JaxRaffnix/sdr-analog-frontend/README.md

# SDR Analog Frontend

The PCB is ordered from [Aisler](https://aisler.net/p/YPFMCLNO).
