JaxRaffnix/sdr-analog-frontend/pcb/main_v2/main_v2_report.txt

PCB statistics report
=====================
- Date: 12.07.2026 20:23:29
- Project: main_v2
- Board name: main_v2

Board
-----
- Width: 204,6625 mm
- Height: 68,5000 mm
- Area: 14019,381 mm²
- Front copper area: 12829,991 mm²
- Back copper area: 487,205 mm²
- Min track clearance: 0,1190 mm
- Min track width: 0,2000 mm
- Min drill diameter: 0,3048 mm
- Board stackup thickness: 1,5790 mm

- Front footprint area: 2778,506 mm²
- Back footprint area: 928,617 mm²
- Front component density: 19,82 %
- Back component density: 6,62 %
Pads
----
- Through hole: 27
- SMD: 516
- Connector: 0
- NPTH: 5
- Castellated: 0
- Press-fit: 0

Vias
----
- Through vias: 806
- Blind vias: 0
- Buried vias: 0
- Micro vias: 0

Components
----------

| | Front Side | Back Side | Total |
|---|---|---|---|
|THT: | 10 | 0 | 10 |
|SMD: | 171 | 0 | 171 |
|Unspecified:  | 10 | 0 | 10 |
|Total: | 191 | 0 | 191 |

Drill holes
-----------

| Count | Shape | X Size | Y Size | Plated | Via/Pad | Start Layer | Stop Layer |
|---|---|---|---|---|---|---|---|
| 796 | Round | 0,3048 mm | 0,3048 mm | PTH | Via | F.Cu | B.Cu |
| 21 | Round | 1,0000 mm | 1,0000 mm | PTH | Pad | F.Cu | B.Cu |
| 10 | Round | 0,4064 mm | 0,4064 mm | PTH | Via | F.Cu | B.Cu |
| 4 | Round | 2,2000 mm | 2,2000 mm | NPTH | Pad | F.Cu | B.Cu |
| 2 | Round | 2,5000 mm | 2,5000 mm | PTH | Pad | F.Cu | B.Cu |
| 2 | Round | 0,8000 mm | 0,8000 mm | PTH | Pad | F.Cu | B.Cu |
| 1 | Round | 1,6000 mm | 1,6000 mm | NPTH | Pad | F.Cu | B.Cu |
| 1 | Round | 3,0000 mm | 3,0000 mm | PTH | Pad | F.Cu | B.Cu |
| 1 | Round | 2,3000 mm | 2,3000 mm | PTH | Pad | F.Cu | B.Cu |
