JaxRaffnix/sdr-analog-frontend/docs/design/Bauteilauswahl.docx

# Bauteilauswahl

SDR Analog Frontend

Alle verlinkten Bauteile sind auf Mouser/Digikey vorrätig

# Software Defined Radio

SDR | Signal | Terminierung | | Peak-to-Peak Differential | Output Power Max | Input Power Max
RFSoC_RM_A3 (https://www.realdigital.org/hardware/rfsoc-4x2) | 900 – 1000 Mhz | 100 Ohm | | 4,8 V | -18,5 – 6,6 dBm | 14m 6 dBm

Am ADC und DAC des RFSoC befinden sich MABA-011118 Baluns, diese erzeugen ein Single-Ended 50 Ohm Signal!

# Power

Power Supply über 5V USB- Gerät.

https://www.amazon.de/AC-DC-Netzteil-Stecker-Plug/dp/B0BYS9Y2B6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

Input | Spannung | Strom Max | Leistung Max
USB A Jack (https://www.mouser.de/ProductDetail/Wurth-Elektronik/692122030100?qs=e5m3IbTHPW%252BwkSEzX%252BzXuw%3D%3D) | 5 V | 1.8 A | 9 W

Power Management | Input Voltage | Output Current Max | Kosten
AP22804AW5-7 (https://www.mouser.de/ProductDetail/Diodes-Incorporated/AP22804AW5-7?qs=lqAf%2FiVYw9hgcUuNhFapmA%3D%3D) | 2,7 – 5,5 V | 2,5 A | 0,32 €

3,3 V Linear Dropout-Regulator | Input Voltage Max | Output Current Max | Kosten
LT3042 (https://www.mouser.de/ProductDetail/Analog-Devices/LT3042EMSEPBF?qs=oahfZPh6IAJ3XP16d20ITw%3D%3D) | 1,8V – 20V | 200 mA | 6,49 €

# Oszillator

Zielfrequenz von 1.5 GHz wird mit temperaturkontrolliertem Oszillator erreicht.

Um aus dem LVDS-Signal einen glatten Sinus ohne Gleichanteil un 50 Ohm Terminierung zu erzeugen, wird ein 1:2 Balun, Tiefpass und Blocking Kondensatoren verwendet.

Das Signal wird gesplittet und für jeweils den Rx und Tx Pfad verstärkt.

Oszillator | Frequenz | Frequenzstabilität | Supply Voltage | Input Current Max | Output | Kosten
ASG-D-X-A-1.500GHZ (https://www.mouser.de/ProductDetail/ABRACON/ASG-D-X-A-1.500GHZ?qs=EvNa9vf1TdY1witycQX%252Bjg%3D%3D) | 1,5 GHz | 50 ppm | 3,3 V | 40 mA | LVDS | 13,62 €
ASGTX-P-1.500GHz-1 (https://www.mouser.de/ProductDetail/ABRACON/ASGTX-P-1.500GHz-1?qs=6DDkx98%252BHnBmxjjunHEfJg%3D%3D) | 1.5 GHz | 1 ppm | 3,3 V | 60 mA | LVPECL | 72,01 €

RF Balun | Frequenzbereich | Insertion Loss | Input Termination | Ouptut Termination | Kosten
XMB0220K1-50100G (https://www.mouser.de/ProductDetail/TTM-Technologies/XMB0220K1-50100G?qs=4dK74SdgGtzjn4qZiEqOfQ%3D%3D) | 180 – 1900 MHz | | 50 Ohm | 100 Ohm | 16,68 €

Tiefpass | Frequenz | Insertion Loss | Termination | Kosten
LFCN-1700D+ (https://www.mouser.de/ProductDetail/Mini-Circuits/LFCN-1700D%2b?qs=xZ%2FP%252Ba9zWqZu7I6a3Z3VTA%3D%3D) | DC – 1700 MHz | | 50 Ohm | 11,32 €

Power Splitter | Frequenz | Termination | Kosten
PD0922J5050S2HF (https://www.mouser.de/ProductDetail/TTM-Technologies/PD0922J5050S2HF?qs=61pwXRo0i5gy90xR1sGBbQ%3D%3D) | 950 – 2150 MHz | 50 Ohm | 0,72 €

Verstärker | Frequenz | Gain | P1dB | Insertion Loss | Drain Voltage | Current Max | Kosten
SPF5043Z (https://www.mouser.de/ProductDetail/Qorvo/SPF5043Z?qs=p6lVfQR1GSoUob90DTnCEA%3D%3D) | 50 – 4000 MHz | 12.9 dB @ 1960 MHz | | | 5 V | 100 mA | 5,25 €

# Mischer

HF Mixer | Frequenz | P1dB | Insertion Loss | LO Power | IF Current | RF Power | Kosten
RMaS-30+ (https://www.mouser.de/ProductDetail/Mini-Circuits/RMS-30%2b?qs=Znm5pLBrcAIBkcPltAJrPg%3D%3D) | 200 – 3000 MHz | | | 7 dBm | 40mA | 200 mW | 14,72 €

# Bandpass Zielfrequen

Der Bandpass sorgt dafür, dass nur die Zielfrequenz verarbeitet wird im Rx oder Tx pfad.

Bandpass | Frequenz | P1dB | Termination | Kosten
2450BP08A0100001T (https://www.mouser.de/ProductDetail/Johanson-Technology/2450BP08A0100001T?qs=jRuttqqUwMTNv6S8vKwCpQ%3D%3D) | 2400 – 2500 MHz | 22.7 dBm | 50 Ohm | 1,14 € x2

# Transmitter

Verstärker | Frequenz | P1dB | Insertion Loss | Max Input Power | Voltage | Strom Max | Kosten
SE2576L-R (https://www.mouser.de/ProductDetail/Skyworks-Solutions-Inc/SE2576L-R?qs=WMHGlxXAKT%252BgTam3WBvNxQ%3D%3D) | 2400 – 2500 MHz | 32 dBm | | 12.0 dBm | 5 V | 500 mA | 1,31 €

# Receiver

Low Noise Amplifier | Frequenz | Gain | P1dB | Rauschzahl | Insertion Loss | Spannung | Strom Max | Kosten
HMC374 (https://www.mouser.de/ProductDetail/Analog-Devices/HMC374E?qs=pceeu5JH%2FH8ggZVEBU5WpA%3D%3D) | 2.0 - 3.0 GHz | 9 dB | 22 dBm | 1.5 dB | | 5 V | 90 mA | 7,64 €

Bandpass | Frequenz | P1dB | Insertion Loss | Termination | Kosten
SYBP-92+ (https://www.mouser.de/ProductDetail/Mini-Circuits/SYBP-92%2b?qs=Znm5pLBrcAKU8e7zMrX60g%3D%3D) | 800 – 1000 MHz | | 2.24 dB | 50Ω | 20,92 €

# Power limiter

SKY16602-632LF

Bei digikey: https://www.digikey.de/en/products/detail/skyworks-solutions-inc/SKY16602-632LF/4959401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

# Kleinkram

- PESD5V0L1UL
- Button_Switch_SMD:SW_DIP_SPSTx01_Slide_6.7x4.1mm_W6.73mm_P2.54mm_LowProfile_JPin
- LED_SMD:LED_0603_1608Metric
- Capacitor_Tantalum_SMD:CP_EIA-6032-20_AVX-F
- LQG15HN1N5S02D
- Connector_Coaxial:SMA_Amphenol_132289_EdgeMount
- Connector barrel jack: https://www.mouser.de/ProductDetail/Same-Sky/PJ-063AH?qs=WyjlAZoYn51bQfA53nMcVA%3D%3D

Antenne:

Antenne an Rx out & Tx Out:

ANT-2.4-LCW-SMA

https://www.mouser.de/ProductDetail/TE-Connectivity-Linx-Technologies/ANT-2.4-LCW-SMA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

Peak Gain: 2.8dBi

Average gain: -0.6dBi typical

VSWR: <2:1
