JaxRaffnix/sdr-analog-frontend/docs/design/PCB Kosten.png

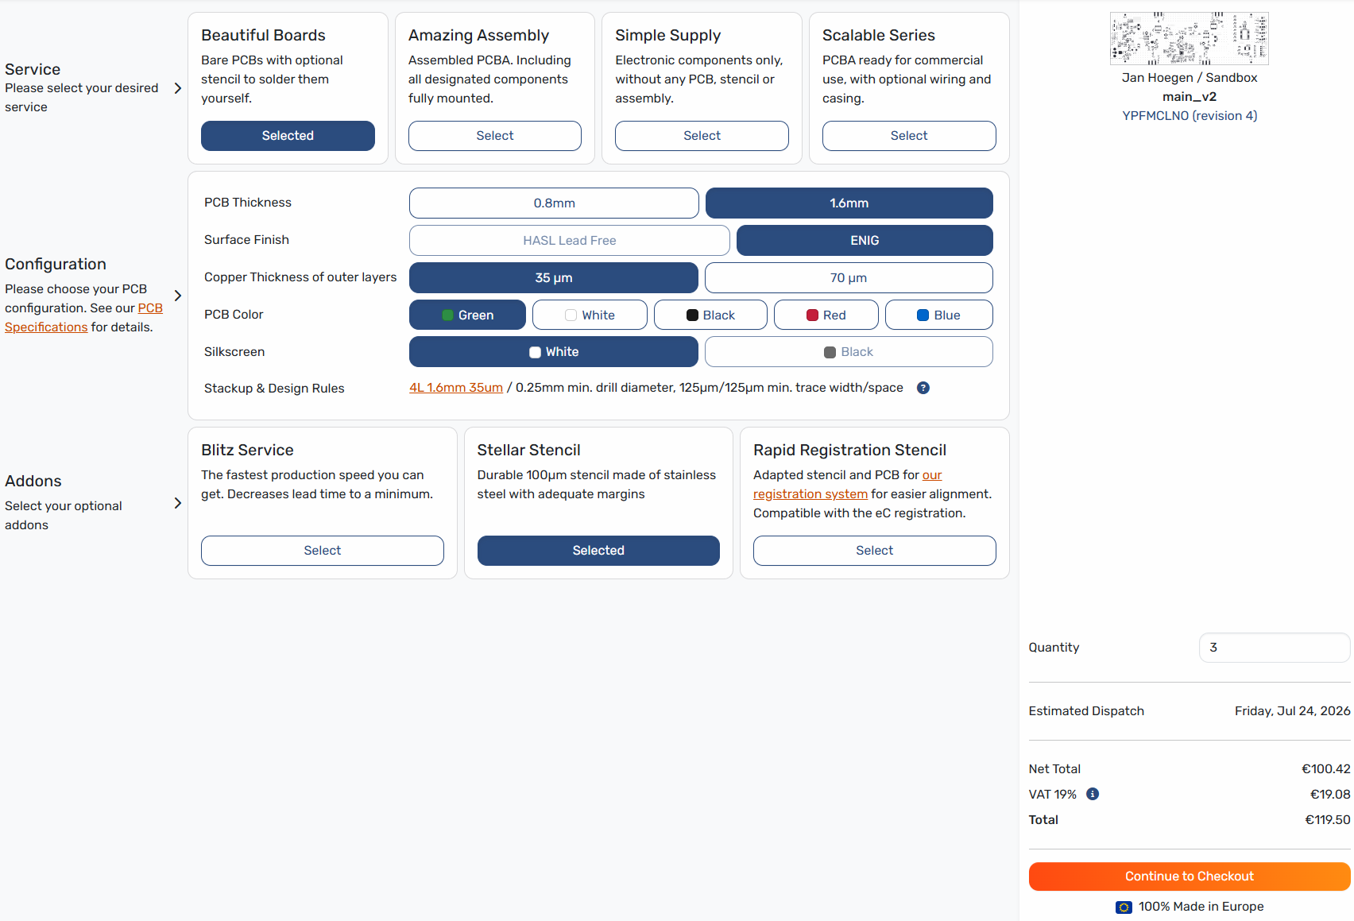
docs/design/PCB Kosten.png
