JaxRaffnix/sdr-analog-frontend/simulation/images/DC Power.png

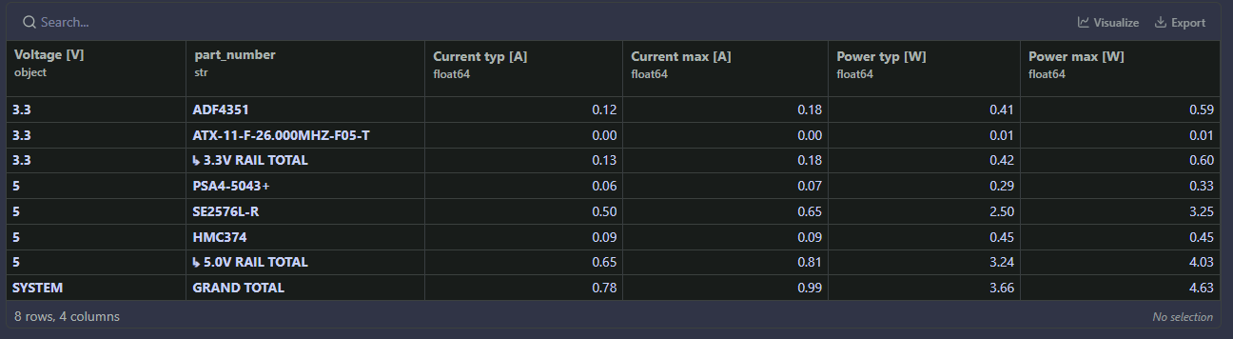
simulation/images/DC Power.png
