JaxRaffnix/sdr-analog-frontend/simulation/images/Oszillator.png

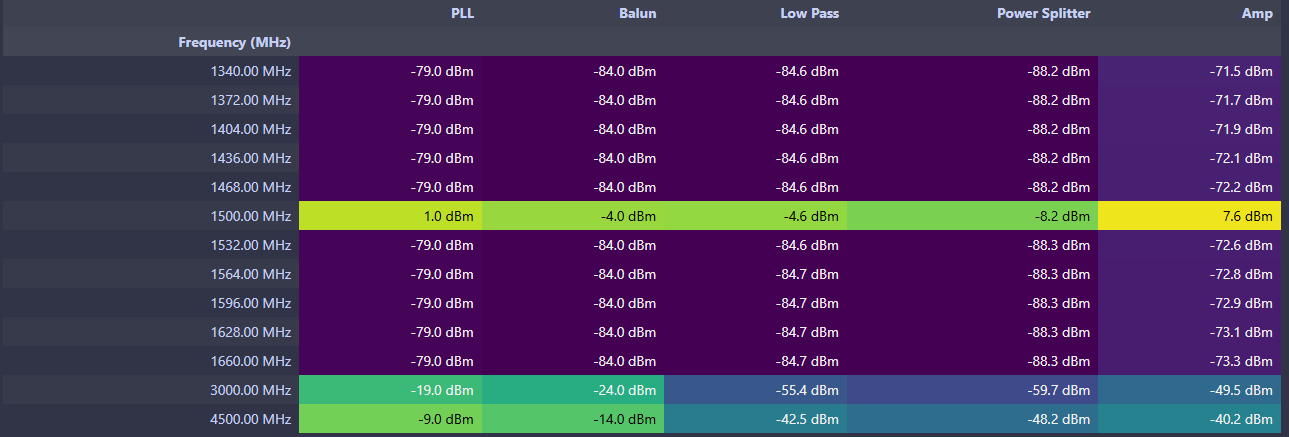
simulation/images/Oszillator.png
