JaxRaffnix/sdr-analog-frontend/simulation/images/Receiver.png

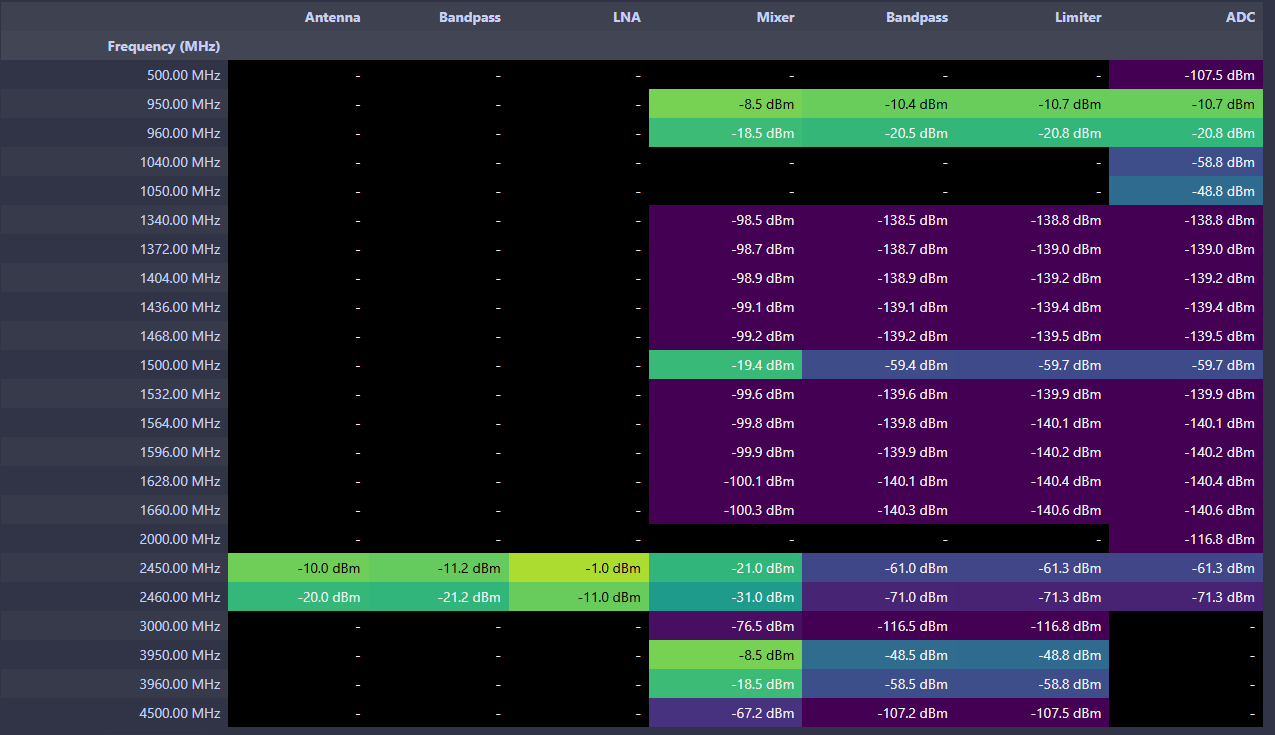
simulation/images/Receiver.png
