JaxRaffnix/sdr-analog-frontend/simulation/images/snr.png

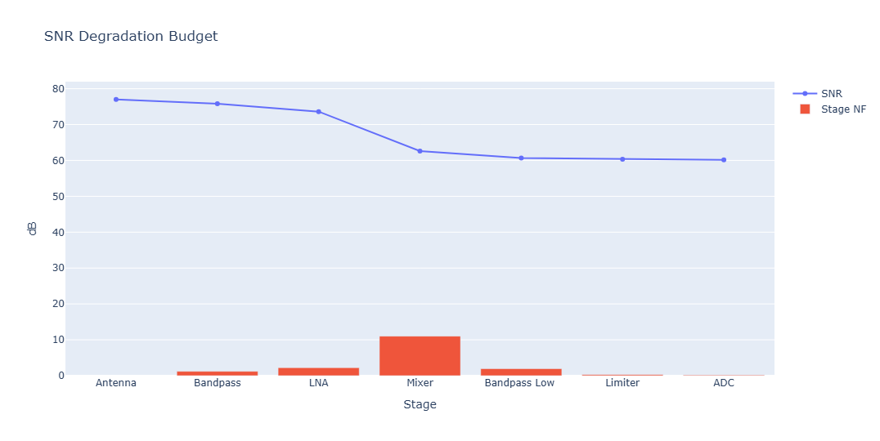
simulation/images/snr.png
