JaxRaffnix/sdr-analog-frontend/simulation/images/Transmitter.png

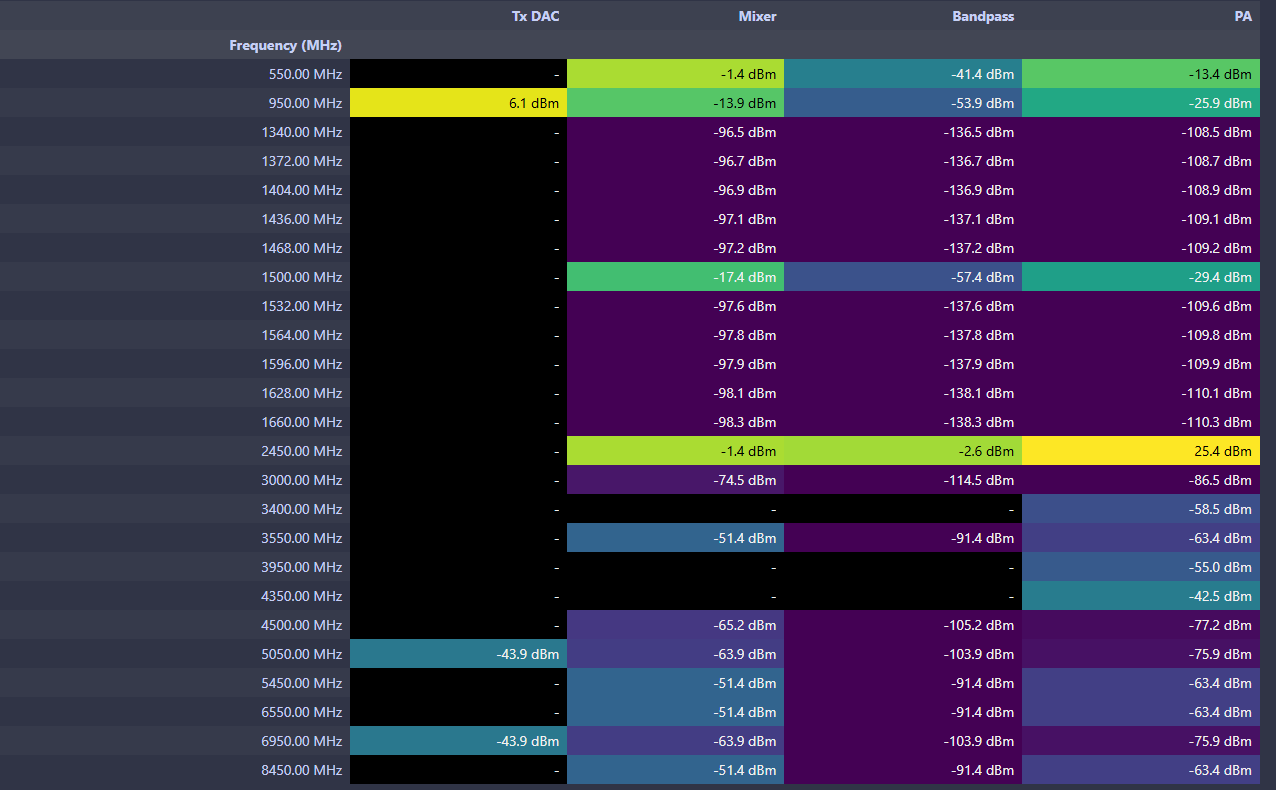
simulation/images/Transmitter.png
