JaxRaffnix/sdr-analog-frontend/docs/hka/Bestellungen/Bestellung.xlsx

Sheet: Tabelle1
Lieferant
Firma |  | Mouser Electronics, Inc.
Straße +HNr |  | Georg-Brauchle-Ring 53 (https://www.mouser.de/contact/)
PLZ,Ort |  | 80992 Munich (https://www.mouser.de/contact/)
ggf. Webseite |  | https://www.mouser.de/en/
E-Mail: (Lieferant) |  | muenchen@mouser.com
Angebotsnummer:
Wer Zahlt?
Kostenstelle:
Fond:
oder PSP Element
Wer will es haben?
Besteller: |  | Jan Hoegen
Raum: |  | N-206
ggf. Betreuer |  | Tristan Itschner
 |  |  | Preise Ohne MwSt!
Stückzahl | Artikel.-Nr. | Beschreibung | Einzel Preis € | Summe € | Bestell-Links
5 | CC0603KPX7R8BB105 (https://www.mouser.de/de/ProductDetail/YAGEO/CC0603KRX7R9BB104) | Kondensator aus mehreren Keramikschichten MLCC - SMD/SMT 25V 1uF X7R 0603 10% HI CV | 0.21 € | 1.03 €
10 | CC0603MRX7R5BB475 (https://www.mouser.de/de/ProductDetail/YAGEO/CC0603MRX7R5BB475) | Kondensator aus mehreren Keramikschichten MLCC - SMD/SMT 6.3V 4.7uF X7R 0603 20% HI CV | 0.46 € | 4.64 €
5 | CC0603KRX7R9BB104 (https://www.mouser.de/de/ProductDetail/YAGEO/CC0603KRX7R9BB104?qs=vTakOoo5QyLvVCYM2ge8LQ%3D%3D) | Kondensator aus mehreren Keramikschichten MLCC - SMD/SMT 50 V 0.1uF X7R 0603 10% | 0.09 € | 0.43 €
5 | TPSF157K010R0200 (https://www.mouser.de/de/ProductDetail/KYOCERA-AVX/TPSF157K010R0200?qs=%2FAyNC%2FU1o91Nx%252BUpVCohjg%3D%3D) | Tantalkondensatoren - fest für SMD 10V 150uF 10% Tol. 200 ESR | 2.82 € | 14.10 €
20 | CQ0402FRNPO9BN100 (https://www.mouser.de/de/ProductDetail/YAGEO/CQ0402FRNPO9BN100) | Kondensator aus mehreren Keramikschichten MLCC - SMD/SMT 50 V 10 pF C0G 0402 1% | 0.16 € | 3.26 €
12 | C0402T101J5GACTU (https://www.mouser.de/de/ProductDetail/KEMET/C0402T101J5GACTU?qs=u4fy%2FsgLU9PLUPqqcVgCTA%3D%3D) | Kondensator aus mehreren Keramikschichten MLCC - SMD/SMT 50V 100pF C0G 0402 5% | 0.78 € | 9.40 €
5 | CM03X5R105M06AH (https://www.mouser.de/de/ProductDetail/KYOCERA-AVX/CM03X5R105M06AH?qs=rkhjVJ6%2F3ELzWF91DLscGA%3D%3D) | Kondensator aus mehreren Keramikschichten MLCC - SMD/SMT KGM03BR50J105MH NEW GLOBAL PN 1uF 20% 6. A 581-KGM03BR50J105MH | 0.10 € | 0.47 €
10 | C0402X7R1A102K020BC (https://www.mouser.de/de/ProductDetail/TDK/C0402X7R1A102K020BC?qs=Zt%252BKPUOg4oeVeDoDR%252BkQnw%3D%3D) | Kondensator aus mehreren Keramikschichten MLCC - SMD/SMT 01005 10V 1000pF X7R 10% T: 0.2mm | 0.13 € | 1.29 €
5 | VJ0402D2R2BXCAJ (https://www.mouser.de/de/ProductDetail/Vishay-Vitramon/VJ0402D2R2BXCAJ) | Kondensator aus mehreren Keramikschichten MLCC - SMD/SMT 0402 2.2pF 200V C0G +/-.01pF HIFREQ | 0.58 € | 2.88 €
5 | 04026W475MAT2A (https://www.mouser.de/de/ProductDetail/KYOCERA-AVX/04026W475MAT2A) | Kondensator aus mehreren Keramikschichten MLCC - SMD/SMT 6.3V 4.7Uf 0402 20% | 0.34 € | 1.68 €
5 | VJ0402D150FXCAJ (https://www.mouser.de/de/ProductDetail/Vishay-Vitramon/VJ0402D150FXCAJ) | Kondensator aus mehreren Keramikschichten MLCC - SMD/SMT 0402 15pF 200V C0G 1% HI FREQ | 0.56 € | 2.80 €
5 | CC0402KRX5R8BB104 (https://www.mouser.de/de/ProductDetail/YAGEO/CC0402KRX5R8BB104?qs=KosDah%252BIqW%252Br%2Fi6bZws5wg%3D%3D) | Kondensator aus mehreren Keramikschichten MLCC - SMD/SMT 25 V 0.1uF X5R 0402 10% | 0.09 € | 0.43 €
5 | GCM1555C1H3R2CA16D (https://www.mouser.de/de/ProductDetail/Murata-Electronics/GCM1555C1H3R2CA16D?qs=b6dFT0v%2Fxb9um9LTQ3aBBQ%3D%3D) | Kondensator aus mehreren Keramikschichten MLCC - SMD/SMT 3.2 pF 50 VDC 0.25 pF 0402 C0G (NP0) AEC-Q200 | 0.13 € | 0.65 €
10 | 0402YU2R4BAT2A (https://www.mouser.de/de/ProductDetail/KYOCERA-AVX/0402YU2R4BAT2A?qs=ZwvTZoB9SO%2F9xc3E5Q%252BCrg%3D%3D) | Kondensator aus mehreren Keramikschichten MLCC - SMD/SMT 16V 2.4pF C0G 0402 0 .1pF | 0.12 € | 1.20 €
5 | TRJC475K035RRJ (https://www.mouser.de/de/ProductDetail/KYOCERA-AVX/TRJC475K035RRJ?qs=utR%252BHFm0FzLRVcCCl%252BXb7w%3D%3D) | Tantalkondensatoren - fest für SMD 4.7uF +/-10% 35V | 0.90 € | 4.52 €
5 | VJ0603Y102MXAAC (https://www.mouser.de/de/ProductDetail/Vishay-Vitramon/VJ0603Y102MXAAC?qs=tKBoUWxeOJbblqoMJ9HNGg%3D%3D) | Kondensator aus mehreren Keramikschichten MLCC - SMD/SMT 1000pF 50volts X7R 20% | 0.17 € | 0.86 €
10 | CC0402JPNPO9BN151 (https://www.mouser.de/de/ProductDetail/YAGEO/CC0402JPNPO9BN151?qs=tS%2FAHvPQ%2F54Y2RC7yI%252Bzfg%3D%3D) | Kondensator aus mehreren Keramikschichten MLCC - SMD/SMT 50 V 150pF C0G 0402 5% | 0.09 € | 0.86 €
5 | 06035C331M4T2A (https://www.mouser.de/de/ProductDetail/KYOCERA-AVX/06035C331M4T2A?qs=ZBeOGGPQgEHm0YWrnTdMuA%3D%3D) | Kondensator aus mehreren Keramikschichten MLCC - SMD/SMT 50V 330pF X7R 0603 2 0% AEC-Q200 | 0.21 € | 1.03 €
5 | VJ1206A331JXAAT (https://www.mouser.de/de/ProductDetail/Vishay-Vitramon/VJ1206A331JXAAT?qs=2M%252BU6H05pn89jvT56Cs8tw%3D%3D) | Kondensator aus mehreren Keramikschichten MLCC - SMD/SMT 330pF 50volts C0G 5% | 0.32 € | 1.59 €
5 | CC1206KFX5R7BB106 (https://www.mouser.de/de/ProductDetail/YAGEO/CC1206KFX5R7BB106?qs=mzRxyRlhVdtbHnIGelyb5g%3D%3D) | Kondensator aus mehreren Keramikschichten MLCC - SMD/SMT 16V 10uF X5R 1206 10% HI CV | 0.40 € | 2.02 €
25 | CC0402KRX7R7BB104 (https://www.mouser.de/de/ProductDetail/YAGEO/CC0402KRX7R7BB104?qs=AgBp2OyFlx%252BSOyhfyS7hpw%3D%3D) | Kondensator aus mehreren Keramikschichten MLCC - SMD/SMT 16 V 0.1uF X7R 0402 10% | 0.09 € | 2.15 €
5 | 04023A1R0DAT2A (https://www.mouser.de/de/ProductDetail/KYOCERA-AVX/04023A1R0DAT2A?qs=FkeSXReRH1vgN2x1fywzxw%3D%3D) | Kondensator aus mehreren Keramikschichten MLCC - SMD/SMT 25V 1pF C0G 0402 .5p F Tol | 0.15 € | 0.78 €
5 | AC0402KRX7R9BB272 (https://www.mouser.de/de/ProductDetail/YAGEO/AC0402KRX7R9BB272?qs=iHX4uCgIbgNWchYmcffrcg%3D%3D) | Kondensator aus mehreren Keramikschichten MLCC - SMD/SMT 50V 2700pF X7R 0402 10% AEC-Q200 | 0.09 € | 0.43 €
5 | CC0402KRX7R7BB393 (https://www.mouser.de/de/ProductDetail/YAGEO/CC0402KRX7R7BB393?qs=5q%252BqlK8CmJSJTmxHu%252BIslQ%3D%3D) | Kondensator aus mehreren Keramikschichten MLCC - SMD/SMT 16V 0.039uF X7R 0402 10% | 0.09 € | 0.43 €
5 | AC0402KRX7R9BB122 (https://www.mouser.de/de/ProductDetail/YAGEO/AC0402KRX7R9BB122?qs=W0yvOO0ixfHbVYdJnLy%252BqQ%3D%3D) | Kondensator aus mehreren Keramikschichten MLCC - SMD/SMT 50V 1200pF X7R 0402 10% AEC-Q200 | 0.09 € | 0.43 €
5 | VJ0402A121JXAAC (https://www.mouser.de/de/ProductDetail/Vishay-Sprague/VJ0402A121JXAAC?qs=3Pj1lnMdkfqiKcr%252BAQDyOQ%3D%3D) | Kondensator aus mehreren Keramikschichten MLCC - SMD/SMT VJ0402A121JXAAC00 | 0.33 € | 1.64 €
 |  |  |  | 0.00 €
5 | GRM1555CYA103GE01J (https://www.mouser.de/de/ProductDetail/Murata-Electronics/GRM1555CYA103GE01J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) | Kondensator aus mehreren Keramikschichten MLCC - SMD/SMT 0.01 uF 35 VDC 2% 0402 C0G (NP0) | 0.14 € | 0.69 €
3 | DESD5V0U1BL-7B | ESD Protection Diodes / TVS Diodes LowCap BiDirectional 1Ch TVS 3A 250mW | 0.21 € | 0.62 €
6 | SM0805GC (https://www.mouser.de/de/ProductDetail/Bivar/SM0805GC?qs=umy9uXsUyyaRZQCOkrRsOQ%3D%3D) | Einfarbige LEDs leds Green 568nm Water Clear | 0.87 € | 5.21 €
5 | LSM0805412V (https://www.mouser.de/de/ProductDetail/VCC/LSM0805412V?qs=T3oQrply3y%2F3hzU4lskNyg%3D%3D) | Einfarbige LEDs leds 0805 2V 100mcd Red | 0.28 € | 1.38 €
2 | 28C0236-0JW-10 | Ferrite Beads 998ohms 100MHz 5A Thru-hole | 1.14 € | 2.28 € | https://www.mouser.de/en/ProductDetail/Laird/28C0236-0JW-10?qs=wjes1ZhMGKc2BBahb2yqoA%3D%3D
5 | BLM18PG121SN1D | Ferrite Beads 120 OHM 25% Alternate Sizing Guide Below | 0.09 € | 0.43 € | https://www.mouser.de/en/ProductDetail/Murata-Electronics/BLM18PG121SN1D?qs=tY8e8KZalarVxhnmnUYZ1A%3D%3D
5 | 2450BP08A0100T (https://www.mouser.de/en/ProductDetail/Johanson-Technology/2450BP08A0100T?qs=YCa%2FAAYMW02eslDA1%2Fi8Rw%3D%3D) | Signal Conditioning PLEASE SEE GLOBAL MFG PN: 2450BP08A0100001T | 0.53 € | 2.62 €
1 | SYBP-92+ | Signal Conditioning Lumped LC Band Pass Filter, 800 - 1000 MHz, 50? | 20.92 € | 20.92 €
 |  |  |  | 0.00 €
2 | AP22811AW5-7 | Power Switch ICs - Power Distribution Load Switch | 0.34 € | 0.67 € | https://www.mouser.de/en/ProductDetail/Diodes-Incorporated/AP22811AW5-7?qs=lqAf%2FiVYw9gUYgIV6BQI1w%3D%3D
2 | RMS-30+ (https://www.mouser.de/en/ProductDetail/Mini-Circuits/RMS-30%2b?qs=Znm5pLBrcAIBkcPltAJrPg%3D%3D) | RF Mixer Level 7, SMT Double Balanced Mixer, RF/LO Freq 200 - 3000 MHz | 14.72 € | 29.44 €
2 | SE2576L-R | RF Amplifier 2.4GHz P1dB 32dBm 5.0Volt 802.11bgn | 1.31 € | 2.62 € | https://www.mouser.de/en/ProductDetail/Skyworks-Solutions-Inc/SE2576L-R?qs=WMHGlxXAKT%252BgTam3WBvNxQ%3D%3D
1 | HMC374SC70E (https://www.mouser.de/en/ProductDetail/Analog-Devices/HMC374SC70E?qs=pceeu5JH%2FH8aAWz5sXQxvw%3D%3D) | RF Amplifier lo Noise amp | 7.08 € | 7.08 €
2 | PGA-103+ | RF Amplifier ML AMPL / SURF MT / 4GHZ RoHS | 2.82 € | 5.64 € | https://www.mouser.de/en/ProductDetail/Mini-Circuits/PGA-103%2b?qs=xZ%2FP%252Ba9zWqZWniifnGTm5A%3D%3D
 |  |  |  |  | https://www.mouser.de/en/ProductDetail/Mini-Circuits/PSA4-5043%2b?qs=xZ%2FP%252Ba9zWqbLkryIxS%2FdVA%3D%3D
2 | 74LVC4T3144PWJ | Buffers & Line Drivers 74LVC4T3144PW/SOT402/TSSOP14 | 0.70 € | 1.41 €
1 | LTC6992CS6-4#TRMPBF | Switching Controllers TimerBlox: V-Controlled Pulse Width Mod | 4.78 € | 4.78 € | https://www.mouser.de/en/ProductDetail/Analog-Devices/LTC6992CS6-4TRMPBF?qs=hVkxg5c3xu8%252B3R%2FY9NegPg%3D%3D
3 | 74LVC244AD-Q100J | Buffers & Line Drivers 74LVC244AD-Q100/SOT163/SO20 | 0.49 € | 1.47 € | https://www.mouser.de/en/ProductDetail/Nexperia/74LVC244AD-Q100J?qs=cbprxTG2Yq%252B6VesrNbHshg%3D%3D
4 | 901-10309 (https://www.mouser.de/en/ProductDetail/Amphenol-RF/901-10309?qs=OWKQh20chuqRtazHxMcApw%3D%3D) | RF Connectors / Coaxial Connectors SMA End Launch PCB Jack | 7.50 € | 30.00 €
2 | PJ-063AH | DC Power Connectors Power Jacks | 1.28 € | 2.56 € | https://www.mouser.de/en/ProductDetail/Same-Sky/PJ-063AH?qs=WyjlAZoYn51bQfA53nMcVA%3D%3D
6 | CONMHF1-SMD-T | RF Connectors / Coaxial Connectors MHF1 Connector Receptacle, Male Pin 50 Ohm Surface Mount Solder | 0.53 € | 3.15 € | https://www.mouser.de/en/ProductDetail/TE-Connectivity-Linx-Technologies/CONMHF1-SMD-T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
2 | D01-9970642 (https://www.mouser.de/en/ProductDetail/Harwin/D01-9970642) | IC & Component Sockets D01 6 WAY SIL HORIZ SMT SKT T&R | 0.68 € | 1.36 €
6 | D01-9970342 (https://www.mouser.de/en/ProductDetail/Harwin/D01-9970342) | IC & Component Sockets D01 3 WAY SIL HORIZ SMT SKT T&R | 0.48 € | 2.89 €
6 | DW-01-07-T-S-200 (https://www.mouser.de/en/ProductDetail/Samtec/DW-01-07-T-S-200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) | Board to Board & Mezzanine Connectors Flexible Board Stacking Header with Fixed Tail Length | 0.09 € | 0.52 €
5 | LQG15HN1N5S02D | HF-Induktivitäten – SMD 1.5 NH +-.3NH | 0.09 € | 0.43 €
5 | CE0603M-27NH (https://www.mouser.de/de/ProductDetail/Bourns/CE0603M-27NH) | HF-Induktivitäten – SMD Ind,0.6x0.3x0.3mm,27nH3%,140mA | 0.09 € | 0.43 €
5 | MLG1005S12NHT000 (https://www.mouser.de/de/ProductDetail/TDK/MLG1005S12NHT000?qs=sGAEpiMZZMv126LJFLh8y5lwrxezZJ61LKcwM8yM6hA%3D) | HF-Induktivitäten – SMD IND 0402 12nH StdQ SMD RF IND | 0.09 € | 0.43 €
5 | LQW2UASR62F00L | HF-Induktivitäten – SMD | 0.34 € | 1.68 €
5 | MLG1005S7N5JTD25 (https://www.mouser.de/de/ProductDetail/TDK/MLG1005S7N5JTD25) | HF-Induktivitäten – SMD IND 0402 7.5nH StdQ AEC Q200 RF IND | 0.10 € | 0.47 €
5 | MLG1005S47NHT000 (https://www.mouser.de/de/ProductDetail/TDK/MLG1005S47NHT000) | HF-Induktivitäten – SMD IND 0402 47nH StdQ SMD RF IND | 0.09 € | 0.43 €
2 | DMP3068L-7 | MOSFETs 30V P-Ch Enh Mode 72mOhm -10V -3.9A | 0.43 € | 0.86 €
2 | 2N7002 (https://www.mouser.de/en/ProductDetail/onsemi/2N7002?qs=0dwsXDNhqlz66WJJhrTFjQ%3D%3D) | MOSFETs N-CHANNEL 60V 115mA | 0.94 € | 1.87 €
10 | AF0603FR-13100KL (https://www.mouser.de/en/ProductDetail/YAGEO/AF0603FR-13100KL?qs=F5EMLAvA7IDemuDutB0AIQ%3D%3D) | Thick Film Resistors - SMD 100kOhms 1/10W 0603 1% AEC-Q200 | 0.09 € | 0.86 €
7 | TNPU06031K00AYEA00 (https://www.mouser.de/en/ProductDetail/Vishay-Dale/TNPU06031K00AYEA00?qs=6Iix%252B7vYeyom8fpR%2FboP3Q%3D%3D) | Thin Film Resistors - SMD 1/10W 1Kohm 0.05% 10ppm | 1.29 € | 9.03 €
20 | AC0603DRE0710KL (https://www.mouser.de/en/ProductDetail/YAGEO/AC0603DRE0710KL?qs=r5DSvlrkXmKh6qngPzSakA%3D%3D) | Thick Film Resistors - SMD 10 k Ohms 100mW 0603 0.5% AEC-Q200 Standard Power Version | 0.14 € | 2.76 €
5 | CRCW0603453KFKEAHP (https://www.mouser.de/en/ProductDetail/Vishay/CRCW0603453KFKEAHP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) | Thick Film Resistors - SMD CRCW0603-HP 100 453K 1% ET1 E3 | 0.18 € | 0.91 €
5 | RT0603FRD07499KL (https://www.mouser.de/en/ProductDetail/YAGEO/RT0603FRD07499KL) | Thin Film Resistors - SMD | 0.10 € | 0.52 €
5 | CRCW060349K9FKEA (https://www.mouser.de/en/ProductDetail/Vishay/CRCW060349K9FKEA) | Thick Film Resistors - SMD 1/8 Watt 49.9Kohms 1% | 0.09 € | 0.43 €
3 | TNPU0603150RBZEN00 (https://www.mouser.de/en/ProductDetail/Vishay/TNPU0603150RBZEN00) | Thin Film Resistors - SMD TNPU0603 150R 0.1% T-16 E52 e3 | 1.97 € | 5.91 €
5 | CRCW060333K2FKTA (https://www.mouser.de/en/ProductDetail/Vishay/CRCW060333K2FKTA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) | Thick Film Resistors - SMD 1/10watt 33.2Kohms 1% | 0.14 € | 0.69 €
5 | CRCW040291R0FKEDHP (https://www.mouser.de/en/ProductDetail/Vishay/CRCW040291R0FKEDHP) | Thick Film Resistors - SMD 91 OHM 1% 1/5W 100PPM | 0.17 € | 0.86 €
10 | CRCW06030000Z0TAHP (https://www.mouser.de/en/ProductDetail/Vishay/CRCW06030000Z0TAHP) | Thick Film Resistors - SMD CRCW0603-HP 0R0 RT1 | 0.79 € | 7.91 €
5 | CRCW060326K7FKEA (https://www.mouser.de/en/ProductDetail/Vishay/CRCW060326K7FKEA) | Thick Film Resistors - SMD 1/8 Watt 26.7Kohms 1% | 0.09 € | 0.43 €
5 | RC0603DR-07150RL (https://www.mouser.de/en/ProductDetail/YAGEO/RC0603DR-07150RL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) | Thick Film Resistors - SMD General Purpose Chip Resistor 0603, 150Ohms, 0.5%, 1/10W | 0.09 € | 0.43 €
5 | TR0603MR-07100RL (https://www.mouser.de/en/ProductDetail/YAGEO/TR0603MR-07100RL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) | Thick Film Resistors - SMD 100Ohms 1/10W 0603 20% | 0.09 € | 0.43 €
5 | RC0603JR-1351RL (https://www.mouser.de/en/ProductDetail/YAGEO/RC0603JR-1351RL) | Thick Film Resistors - SMD General Purpose Chip Resistor 0603, 51Ohms, 5%, 1/10W | 0.10 € | 0.52 €
5 | TNPW0603680RDEEA (https://www.mouser.de/en/ProductDetail/Vishay/TNPW0603680RDEEA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) | Thin Film Resistors - SMD 680ohms .5% 25ppm | 0.38 € | 1.89 €
5 | TNPW0603360RFHEA (https://www.mouser.de/en/ProductDetail/Vishay/TNPW0603360RFHEA) | Thin Film Resistors - SMD TNPW0603 360R 1% T-2 ET1 e3 | 0.16 € | 0.82 €
5 | CRCW06034K70FKEA (https://www.mouser.de/en/ProductDetail/Vishay/CRCW06034K70FKEA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) | Thick Film Resistors - SMD 1/8 Watt 4.7Kohms 1% | 0.09 € | 0.43 €
5 | RCA0402100RJNED (https://www.mouser.de/en/ProductDetail/Vishay-Draloric/RCA0402100RJNED) | Thick Film Resistors - SMD RCA0402 100R 5% 200 ET7 E3 | 0.11 € | 0.56 €
5 | CRCW0402200RJNEE (https://www.mouser.de/en/ProductDetail/Vishay/CRCW0402200RJNEE) | Thick Film Resistors - SMD D10/CRCW0402 200 200R 5% EF4 E3 | 0.18 € | 0.91 €
20 | TR0603MR-07100RL (https://www.mouser.de/en/ProductDetail/YAGEO/TR0603MR-07100RL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) | Thick Film Resistors - SMD 100Ohms 1/10W 0603 20% | 0.09 € | 1.72 €
5 | RT0603BRD0750KL (https://www.mouser.de/en/ProductDetail/YAGEO/RT0603BRD0750KL?qs=sGAEpiMZZMtlubZbdhIBIEgN9MQql2m6ewcteVFRdgU%3D) | Thin Film Resistors - SMD 50K ohm 0.1% 25 ppm High-Precision | 0.09 € | 0.43 €
1 | TDA01H0SB1R | DIP Switches/SIP Switches SM HalfPitch DIP Swt SPST, 1 POS, STerm | 2.66 € | 2.66 € | https://www.mouser.de/en/ProductDetail/CK/TDA01H0SB1R?qs=lOK7l5uMVC87jfMCZ7r7tA%3D%3D
1 | LT3042MPMSE#PBF (https://www.mouser.de/en/ProductDetail/Analog-Devices/LT3042MPMSEPBF?qs=oahfZPh6IAKb5Ne14xofIQ%3D%3D) | LDO Voltage Regulators 20V, 200mA, Ultralow N, Ultrahigh PSRR R | 15.11 € | 15.11 €
 |  |  |  | 5.12 €
1 | ADF4351BCPZ (https://www.mouser.de/en/ProductDetail/Analog-Devices/ADF4351BCPZ?qs=BpaRKvA4VqFCiUOrGPcIQw%3D%3D) | Phase Locked Loops - PLL 34-4400MHz PLL with Integrated VCO | 19.72 € | 19.72 €
2 | PD0922J5050D2HF | Signal Conditioning 950-2150MHz IL .8dB Mini Wilkinson PD | 0.85 € | 1.70 €
1 | XMB0220K1-50100G | Signal Conditioning Broadband High-Performance, 50ohm Unbalanced to 100ohm Balanced Transformer | 17.00 € | 17.00 €
 |  |  |  | 2.43 €
 |  |  | Gesamt | 297.48 €
 |  |  | zzgl. Mwst | 56.52 €
 |  |  | Summe | 354.00 €

Sheet: Tabelle2
Lieferant
Firma |  | DigiKey Germany GmbH
Straße +HNr |  | Theresienhöhe 11A (https://www.mouser.de/contact/)
PLZ,Ort |  | 80339 München, Deutschland
ggf. Webseite |  | https://www.digikey.de/de/help/legal-information
E-Mail: (Lieferant) |  | eu.support@digikey.com
Angebotsnummer:
Wer Zahlt?
Kostenstelle:
Fond:
oder PSP Element
Wer will es haben?
Besteller: |  | Jan Hoegen
Raum: |  | N-206
ggf. Betreuer |  | Tristan Itschner
 |  |  | Preise Ohne MwSt!
Stückzahl | Artikel.-Nr. | Beschreibung | Einzel Preis € | Summe € | Bestell-Links
1 | SKY16602-632LF | RF DIODE PIN 20V 12W 2MLP | 25.83 € | 25.83 € | https://www.digikey.de/de/products/detail/skyworks-solutions-inc/SKY16602-632LF/4959401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
1 | LFCN-1800+ | CER FILTER 2.125GHZ LOW PASS | 12.19 € | 12.19 € | https://www.digikey.de/en/products/detail/mini-circuits/LFCN-1800/13927464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
2 | PSA4-5043+ | RF Amplifier ML AMPL / SURF MOUNT / RoHS | 3.66 € | 7.32 €
1 | ATX-11-F-26.000MHz-F05-T | TCXO Oscillators TCXO 3225 4-SMD 26MHz 500ppb -40C - 85C Clipped Sine Wave 1.68V - 3.63V | 2.43 € | 2.43 €
 |  |  | Gesamt | 47.77 €
 |  |  | zzgl. Mwst | 56.85 €
 |  |  | Summe | 56.85 €

Sheet: Tabelle3
Lieferant
Firma |  | Weyland
Straße +HNr |  | 7500A BEACH ROAD
PLZ,Ort |  | #04-307 THE PLAZA SINGAPORE (199591)
ggf. Webseite |  | https://www.weylan-d.com/
E-Mail: (Lieferant) |  | service@weylan-d.com
Angebotsnummer:
Wer Zahlt?
Kostenstelle:
Fond:
oder PSP Element
Wer will es haben?
Besteller: |  | Jan Hoegen
Raum: |  | N-206
ggf. Betreuer |  | Tristan Itschner
 |  |  | Preise Ohne MwSt!
Stückzahl | Artikel.-Nr. | Beschreibung | Einzel Preis € | Summe € | Bestell-Links
1 | TCCH-80+ | Common Mode Chokes / Filters RF CHOKE / SURF MOUNT / RoHS | 5.12 € | 5.12 € | https://www.weylan-d.com/goods/detail/4311805/
 |  |  | Gesamt | 5.12 €
 |  |  | zzgl. Mwst | 6.09 €
 |  |  | Summe | 6.09 €
