JaxRaffnix/sdr-analog-frontend/docs/hka/Bestellungen/Auslagenerstattung 2.xlsx

Erstattung von Auslagen in begründeten Ausnahmen |  |  |  | Datum
 |  |  |  | 2026-09-17
Sehr geehrte Damen und Herren,
hiermit bitte ich um Erstattung der unten ausgeführten Auslagen auf das folgende Konto:
Name und Funktion1: |  | Jan Hoegen, Student
IBAN2: |  | DE33 1203 0000 1066 2221 81
BIC: |  | BYLADEM1001
Rechnungen und Zahlungsbelege sind beigefügt.
Beschaffungen für die Hochschule müssen auf Rechnung erfolgen und die Rechnung auf die HKA ausgestellt sein. Triftige Begründung, weshalb der Kauf nicht auf Rechnung erfolgen konnte:
Nur bei IT-Beschaffungen, die nicht über SRM gelaufen sind:3
Nur bei Bewirtungen:4
Lieferant | Erläuterung | Betrag in € | Sachkonto | Kostenstelle/ Fonds bzw. PSP-Element
 |  |  | Nur bei Rechnungen ohne SRM-Bestellung.
Mouser | nach Rücksprache mit Tristan Itschner | 28.99
 | Summe: | 28.99 €
Ich bestätige, die Notwendigkeit meiner Auslage für |  |  | SRM-Bestellnummer:5
die HKA und bitte um Erstattung
2026-09-10 |  |  | Sachlich und rechnerisch richtig6
Datum | Unterschrift
 |  |  | Datum | Unterschrift
Datum | Unterschrift Vorgesetzter/Projektleitung
1 z.B. Mitarbeiter/in, Studierende/r, weitere
2 Bankverbindung ist zwingend erforderlich
3 Auslagen ohne vorliegende Genehmigung durch die IT werden nicht erstattet.
4 Pfand, Trinkgelder und persönlich gewährte Rabatte werden nicht erstattet.
5 Auslagen ab 500 € (netto) und GwGs werden erst erstattet, wenn sie in SRM angelegt wurden (Ausnahme: Alles was mit Dienstreisen zu tun hat, ist über die Personalabteilung abzuwickeln und muss nicht in SRM erfasst werden. (Das gilt nicht für Exkursionen!)
6 i.d.R. Beschaffungsbeauftragte/r
