JaxRaffnix/sdr-analog-frontend/docs/hka/Bestellungen/Bestellung 2.xlsx

Lieferant
Firma |  | Mouser Electronics, Inc.
Straße +HNr |  | Georg-Brauchle-Ring 53 (https://www.mouser.de/contact/)
PLZ,Ort |  | 80992 Munich (https://www.mouser.de/contact/)
ggf. Webseite |  | https://www.mouser.de/en/
E-Mail: (Lieferant) |  | muenchen@mouser.com
Angebotsnummer:
Wer Zahlt?
Kostenstelle:
Fond:
oder PSP Element
Wer will es haben?
Besteller: |  | Jan Hoegen
Raum: |  | N-206
ggf. Betreuer |  | Tristan Itschner
 |  |  | Preise Ohne MwSt!
Stückzahl | Artikel.-Nr. | Beschreibung | Einzel Preis € | Summe € | Bestell-Links
5 | CRCW060333K2FKEAC | Dickfilmwiderstände - SMD 1/10W 33.2Kohms 1% Commercial Use | 0.09 € | 0.43 € | https://www.mouser.de/de/ProductDetail/Vishay/CRCW060333K2FKEAC?qs=E3Y5ESvWgWMA%2Fnx63QrUHA%3D%3D
2 | DMP3068L-13 (https://www.mouser.de/de/ProductDetail/Diodes-Incorporated/DMP3068L-13?qs=BvpHGKeVh3oYv%2Fo7o2xLFg%3D%3D) | MOSFETs 30V P-Ch Enh Mode 72mOhm -10V -3.9A | 0.44 € | 0.88 €
5 | LQW15CAR64J00D (https://www.mouser.de/de/ProductDetail/Murata-Electronics/LQW15CAR64J00D?qs=Ih85XBhZ45kF6EpVY%252BTZWA%3D%3D) | HF-Induktivitäten – SMD | 0.35 € | 1.76 €
5 | AISC-0603-R027J-T (https://www.mouser.de/de/ProductDetail/ABRACON/AISC-0603-R027J-T?qs=nwAb7ZGSLg4FkdvwVP4kEA%3D%3D) | HF-Induktivitäten – SMD IND 27.00 nH 0.490 A 190.00 mOhm | 0.18 € | 0.91 €
 |  |  |  | 0.00 €
 |  |  |  | 0.00 €
 |  |  |  | 0.00 €
 |  |  |  | 0.00 €
 |  |  |  | 0.00 €
 |  |  |  | 0.00 €
 |  |  |  | 0.00 €
 |  |  |  | 0.00 €
 |  |  |  | 0.00 €
 |  |  |  | 0.00 €
 |  |  |  | 0.00 €
 |  |  |  | 0.00 €
 |  |  |  | 0.00 €
 |  |  |  | 0.00 €
 |  |  |  | 0.00 €
 |  |  |  | 0.00 €
 |  |  |  | 0.00 €
 |  |  |  | 0.00 €
 |  |  |  | 0.00 €
 |  |  |  | 0.00 €
 |  |  |  | 0.00 €
 |  |  |  | 0.00 €
 |  |  |  | 0.00 €
 |  |  |  | 0.00 €
 |  |  | Gesamt | 3.98 €
 |  |  | zzgl. Mwst | 0.76 €
 |  |  | Summe | 4.73 €
