JaxRaffnix/sdr-analog-frontend/pcb/documents/schematic.pdf

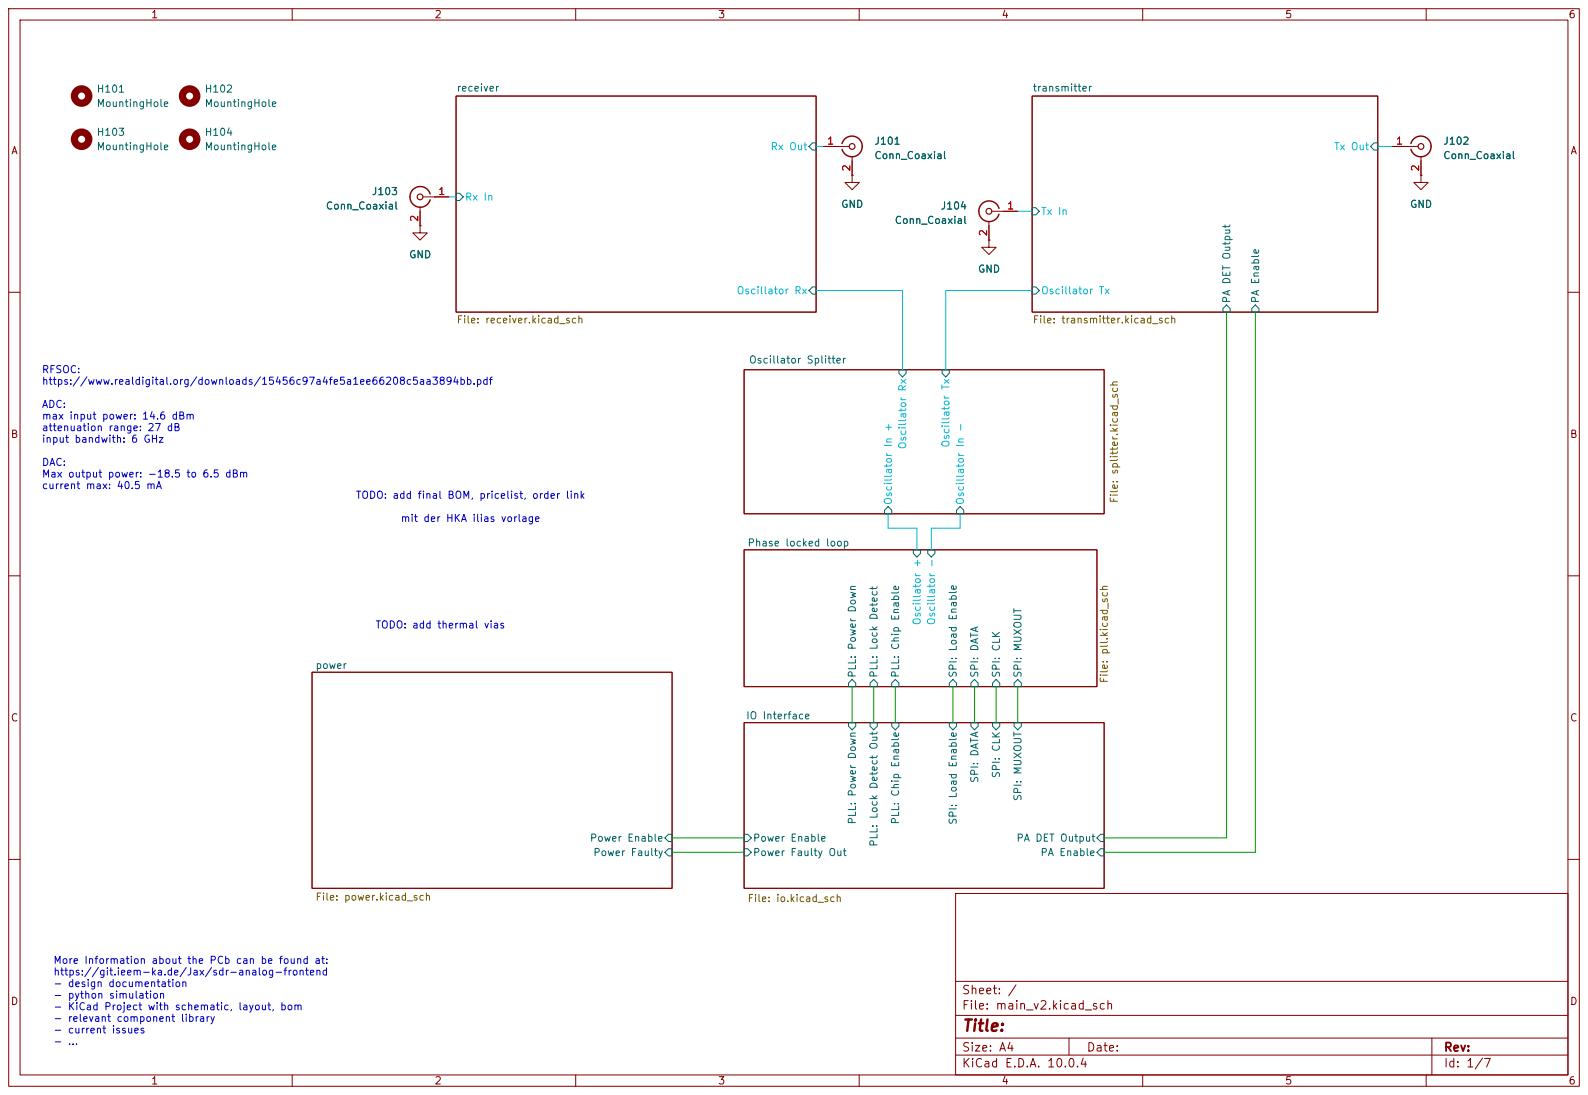
[picture p9: page 1]

TODO: add final BOM, pricelist, order link mit der HKA ilias vorlage RFSOC: https://www.realdigital.org/downloads/15456c97a4fe5a1ee66208c5aa3894bb.pdf ADC: max input power: 14.6 dBm

attenuation range: 27 dB
input bandwith: 6 GHz DAC: Max output power: -18.5 to 6.5 dBm

current max: 40.5 mA More Information about the PCb can be found at: https://git.ieem-ka.de/Jax/sdr-analog-frontend - design documentation - python simulation - KiCad Project with schematic, layout, bom

Power Enable Power Faulty power File: power.kicad_sch

- relevant component library - current issues - ...

Size: A4 | Rev:
KiCad E.D.A. 10.0.4 | Id: 1/7

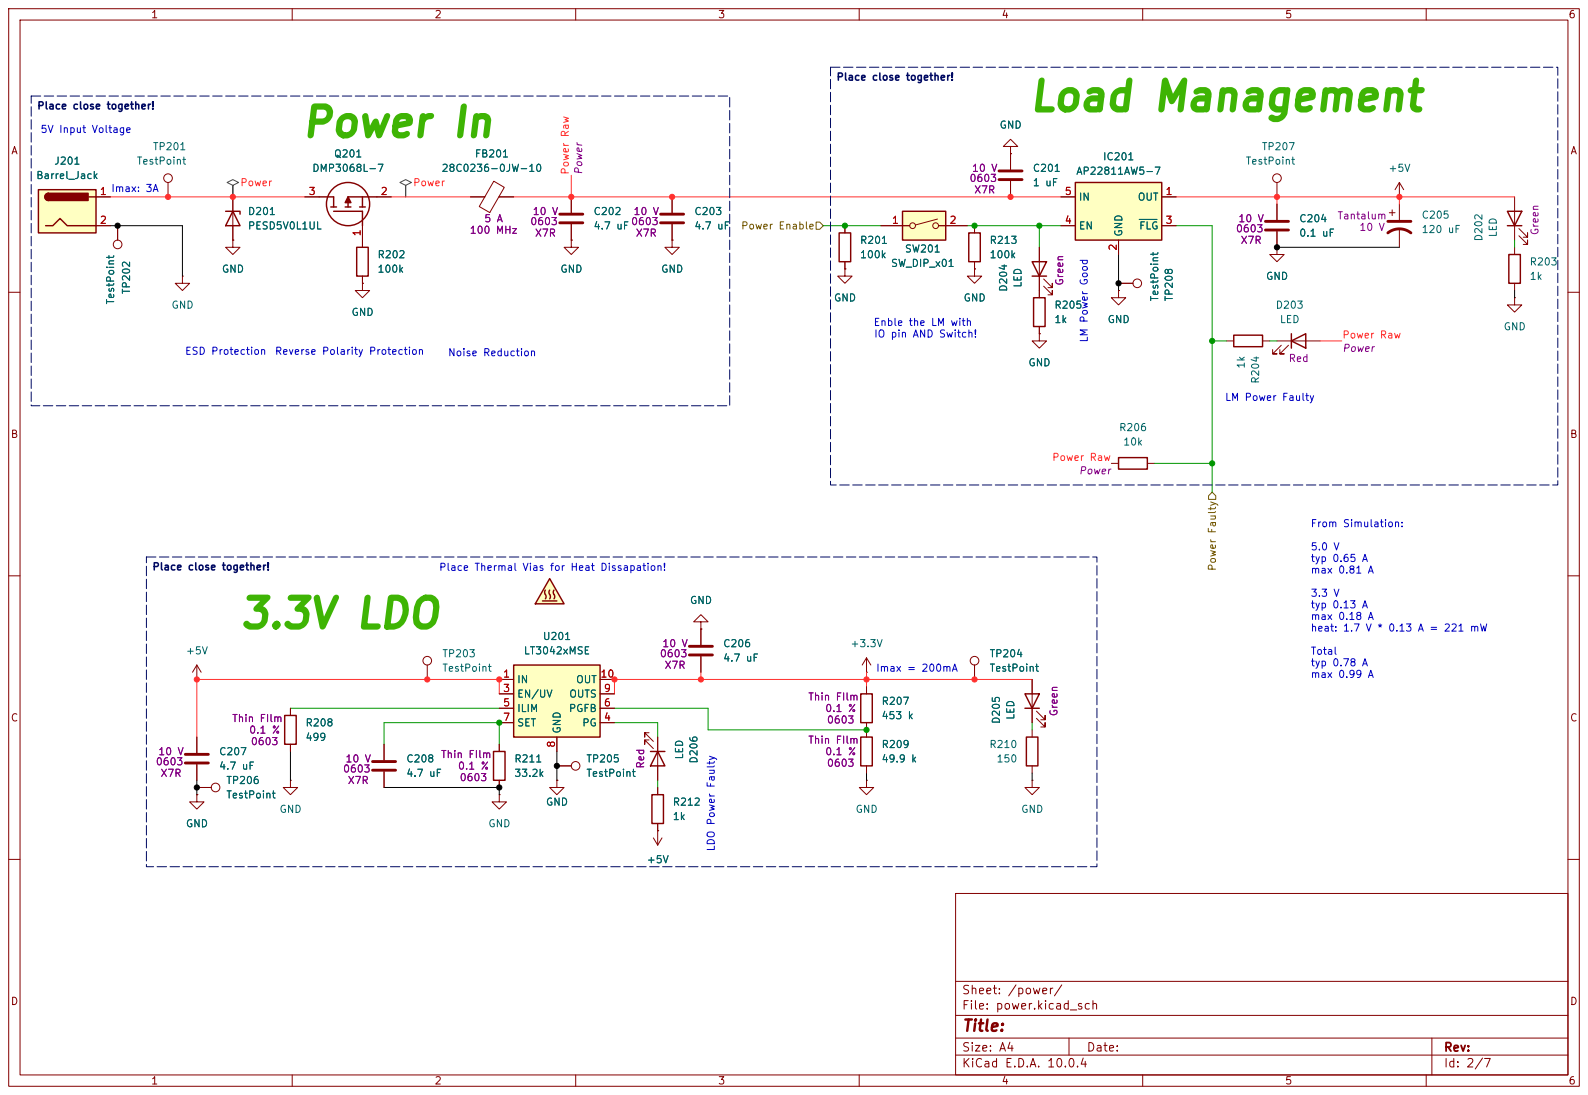
[picture p10: page 2]

LM Power Faulty TP202 TestPoint J201 Barrel_Jack 1

IO pin AND Switch!

Imax = 200mA Place Thermal Vias for Heat Dissapation!

typ 0.13 A max 0.18 A heat: 1.7 V * 0.13 A = 221 mW

Total typ 0.78 A max 0.99 A LDO Power Faulty

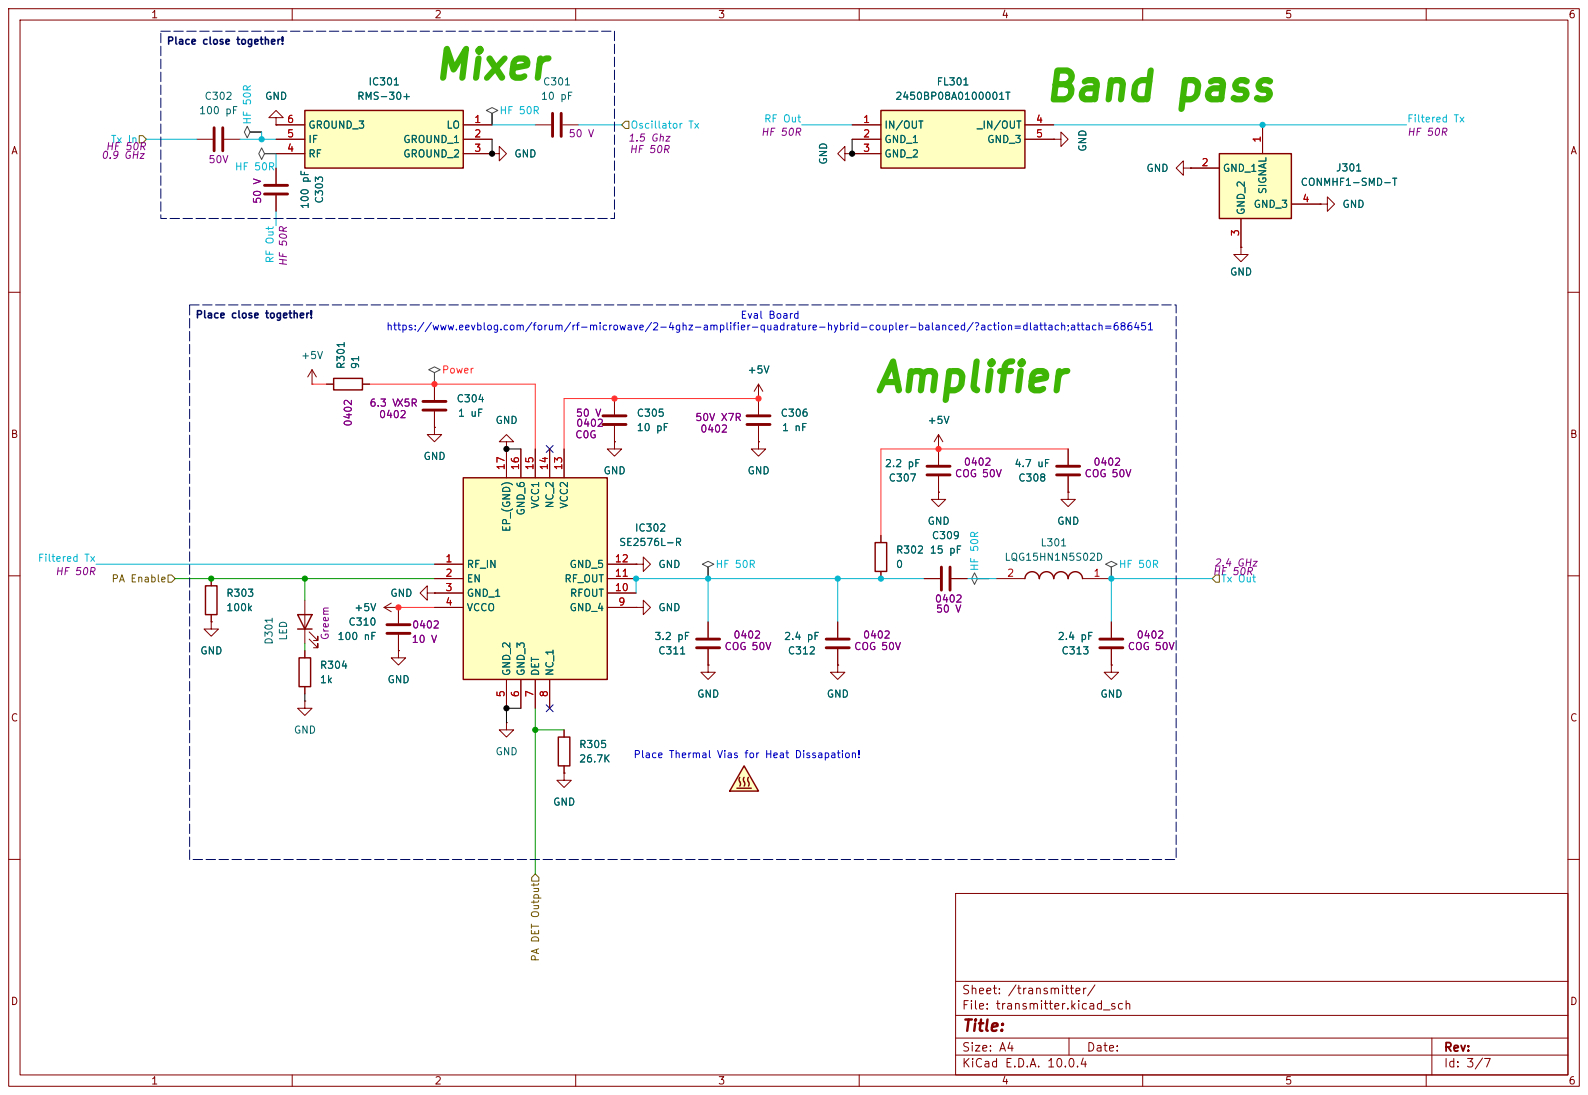
[picture p11: page 3]

RF Out HF 50R

https://www.eevblog.com/forum/rf-microwave/2-4ghz-amplifier-quadrature-hybrid-coupler-balanced/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;attach=686451

Tx Out HF 50R 2.4 GHz PA Enable

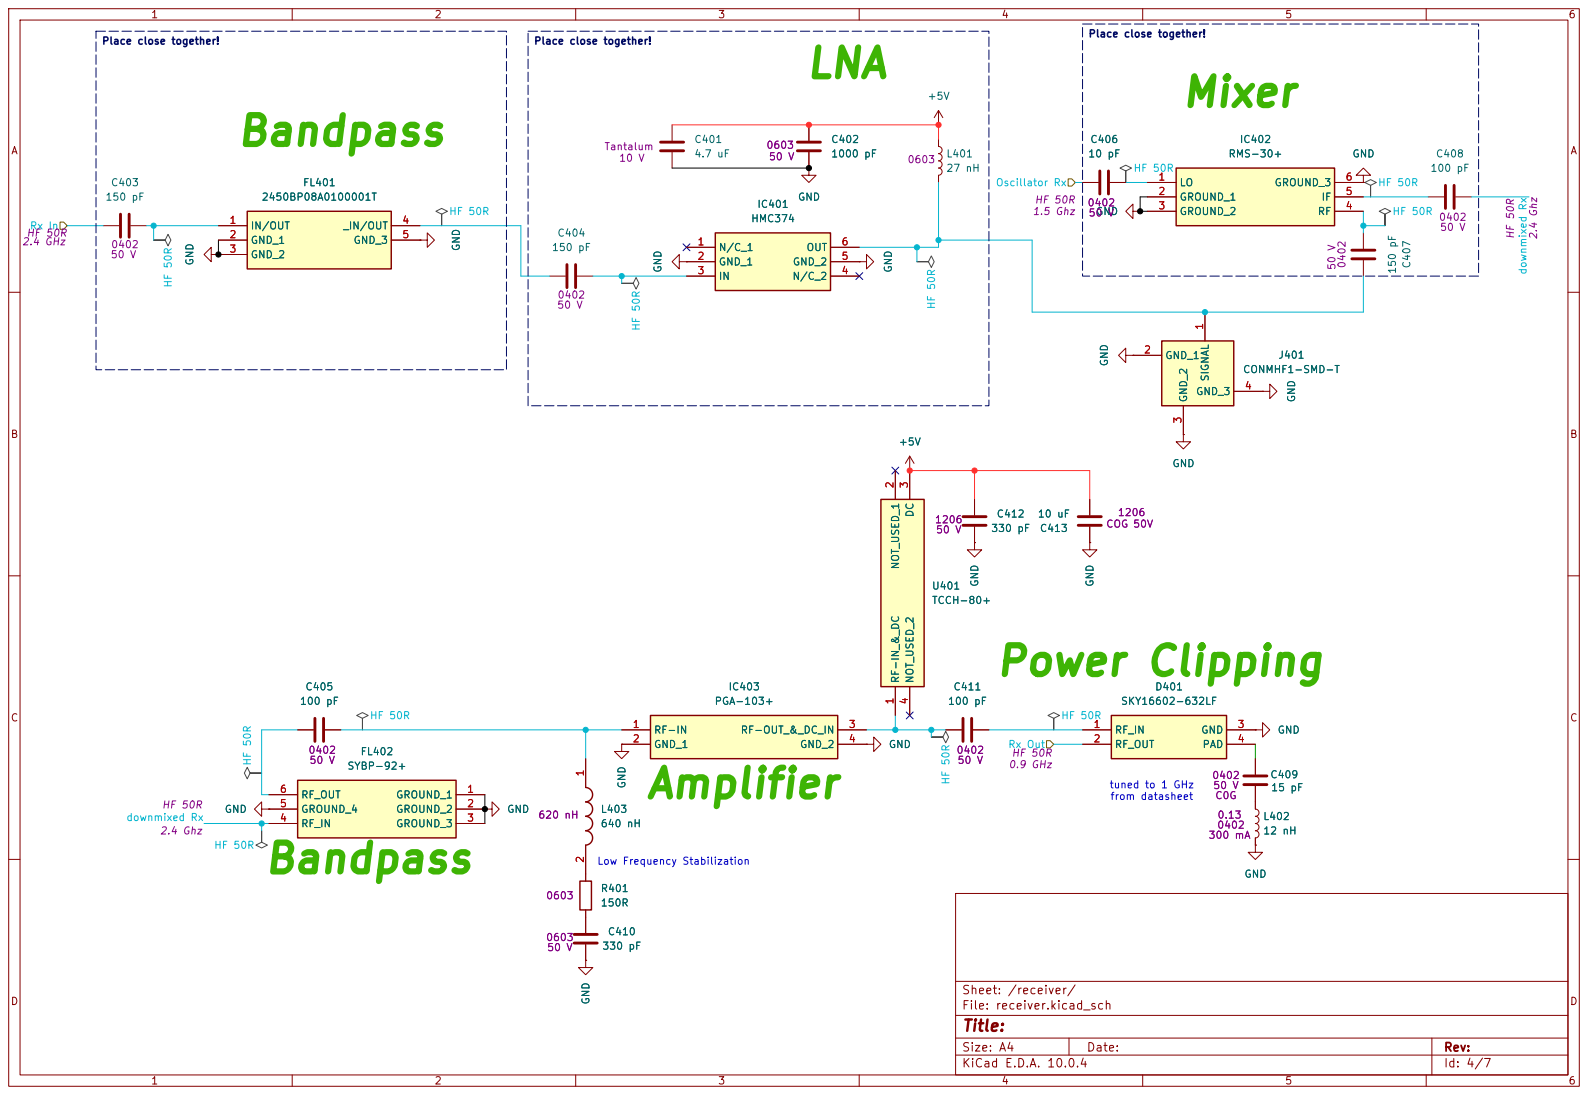
[picture p12: page 4]

Low Frequency Stabilization Amplifier

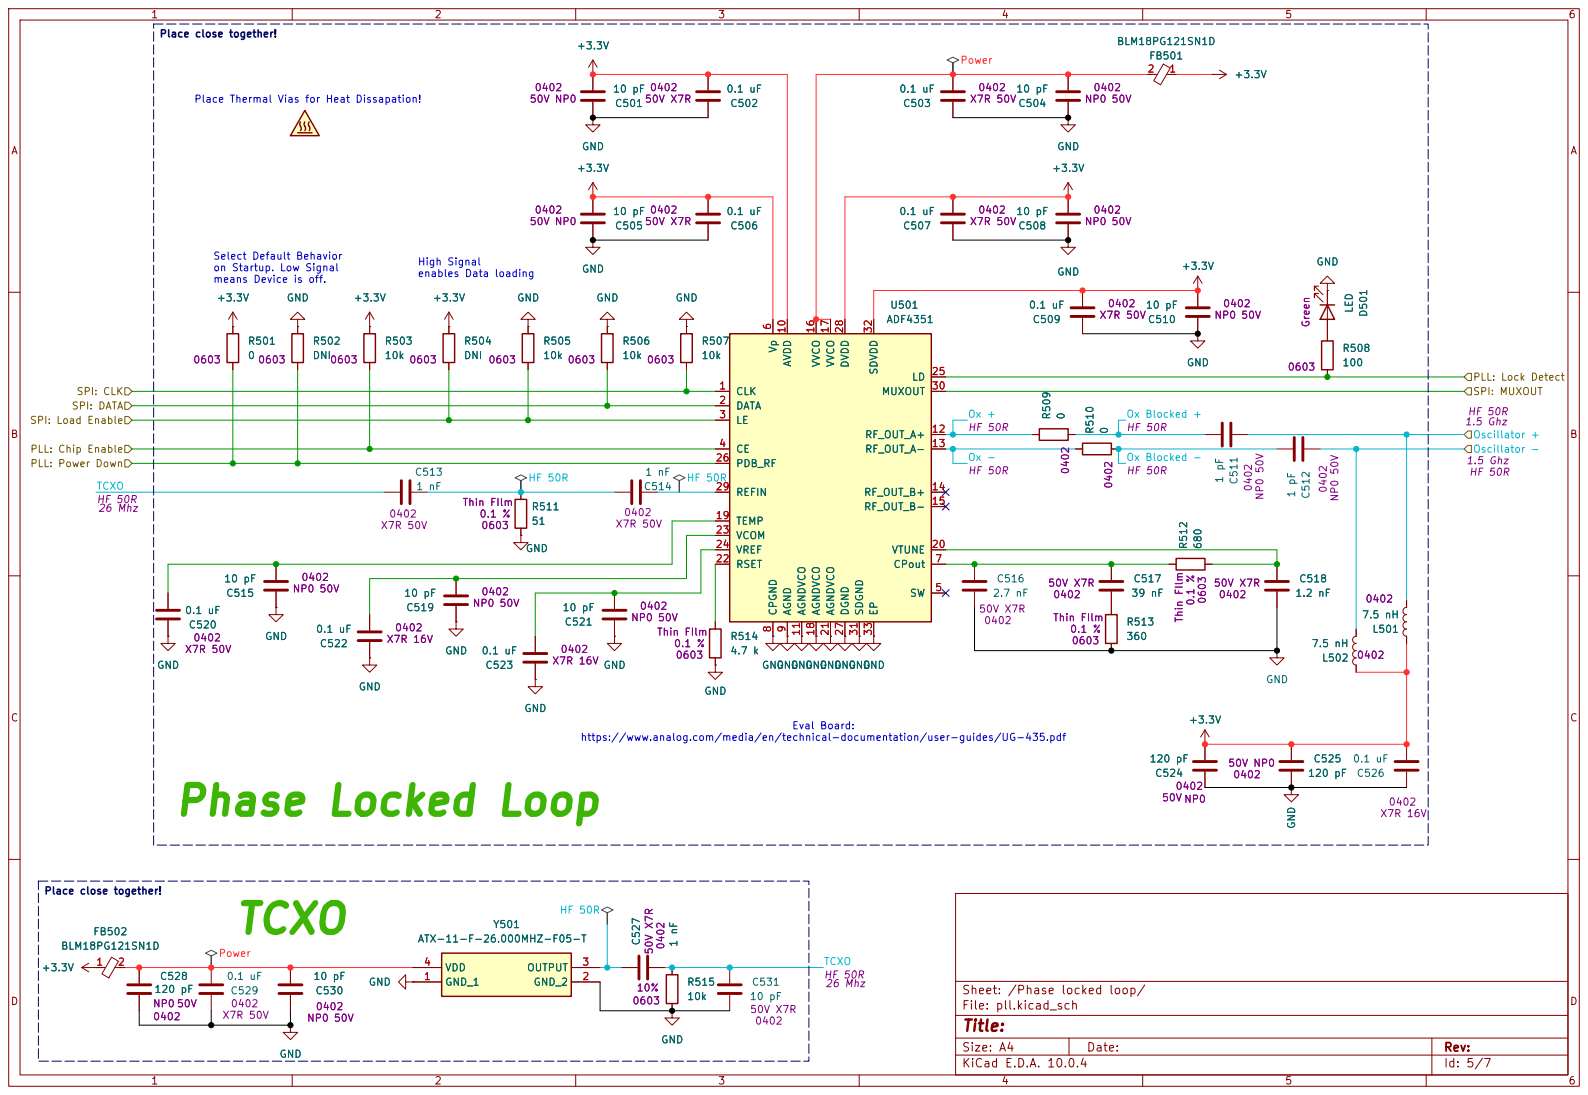
[picture p13: page 5]

Place Thermal Vias for Heat Dissapation!

9 AVDD 10 AGNDVCO 11 RF_OUT_A+ 12 RF_OUT_A- 13 RF_OUT_B+ 14 RF_OUT_B- 15 VVCO 16 VVCO 17 AGNDVCO 18

1.5 Ghz SPI: MUXOUT SPI: Load Enable SPI: CLK

Eval Board: https://www.analog.com/media/en/technical-documentation/user-guides/UG-435.pdf

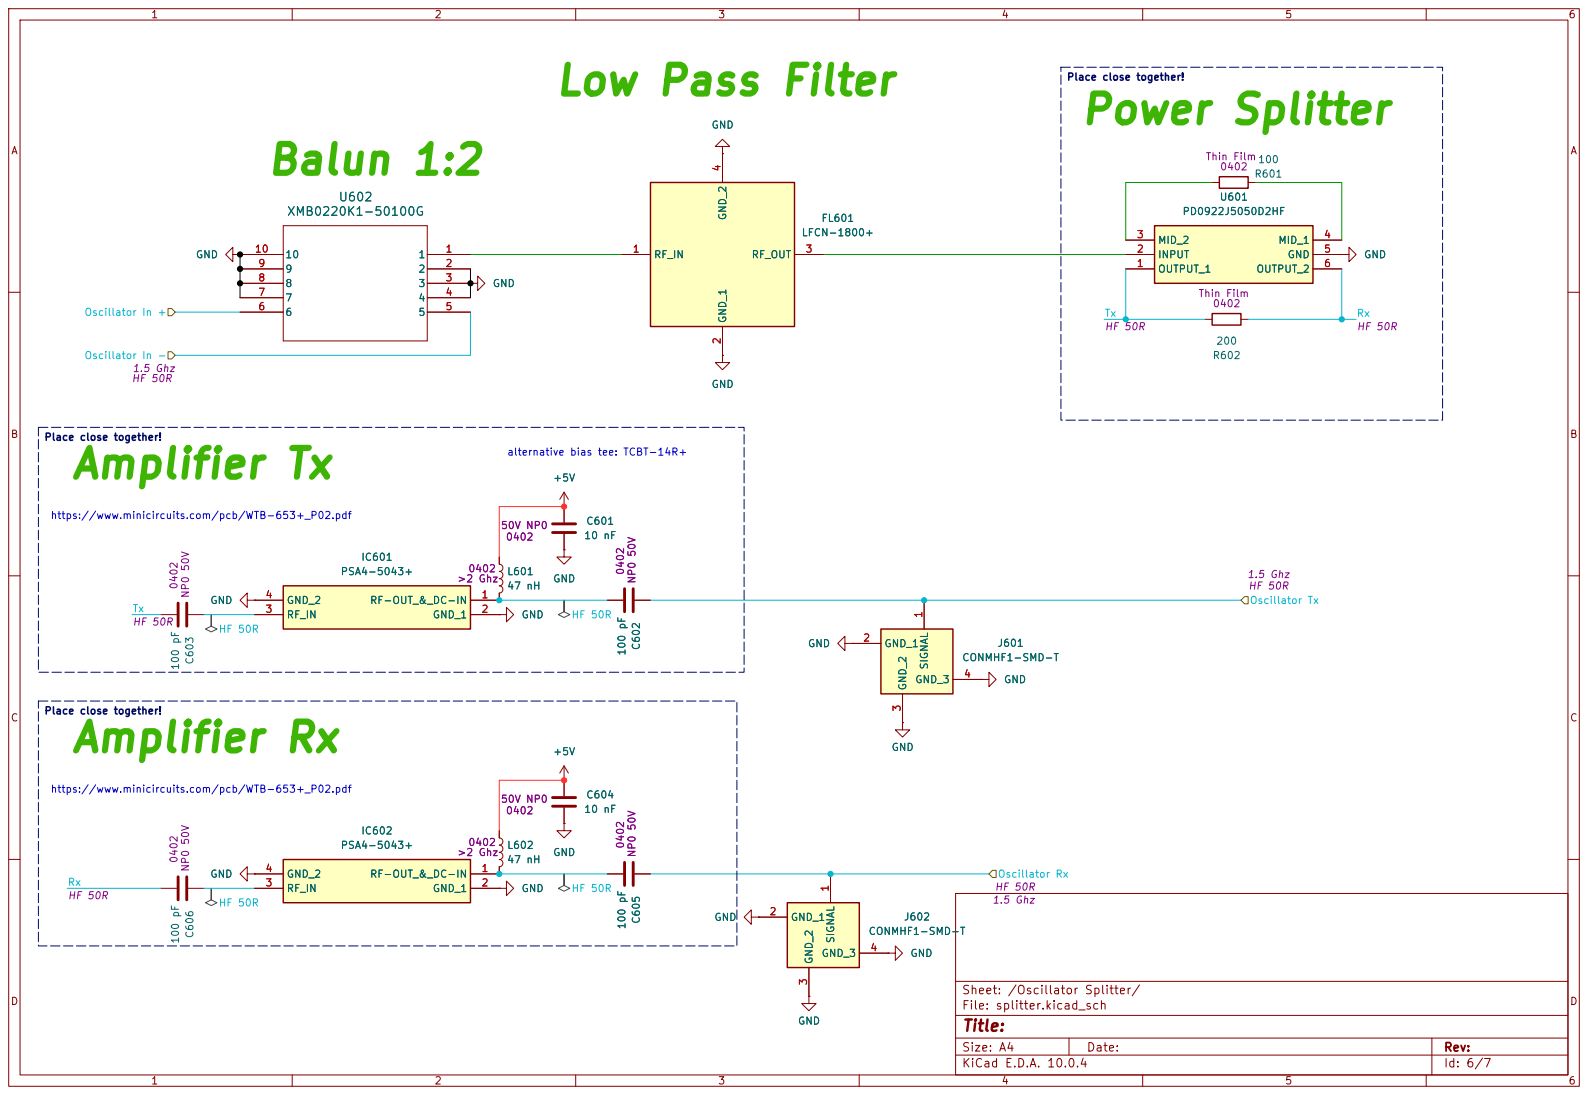
[picture p14: page 6]

Place close together! Place close together! Place close together!

9 9 | 2 2
8 8 | 3 3

https://www.minicircuits.com/pcb/WTB-653+_P02.pdf

3 GND_3 4 GND C605 100 pF 50V NP00402 C602 100 pF 50V NP00402 GND

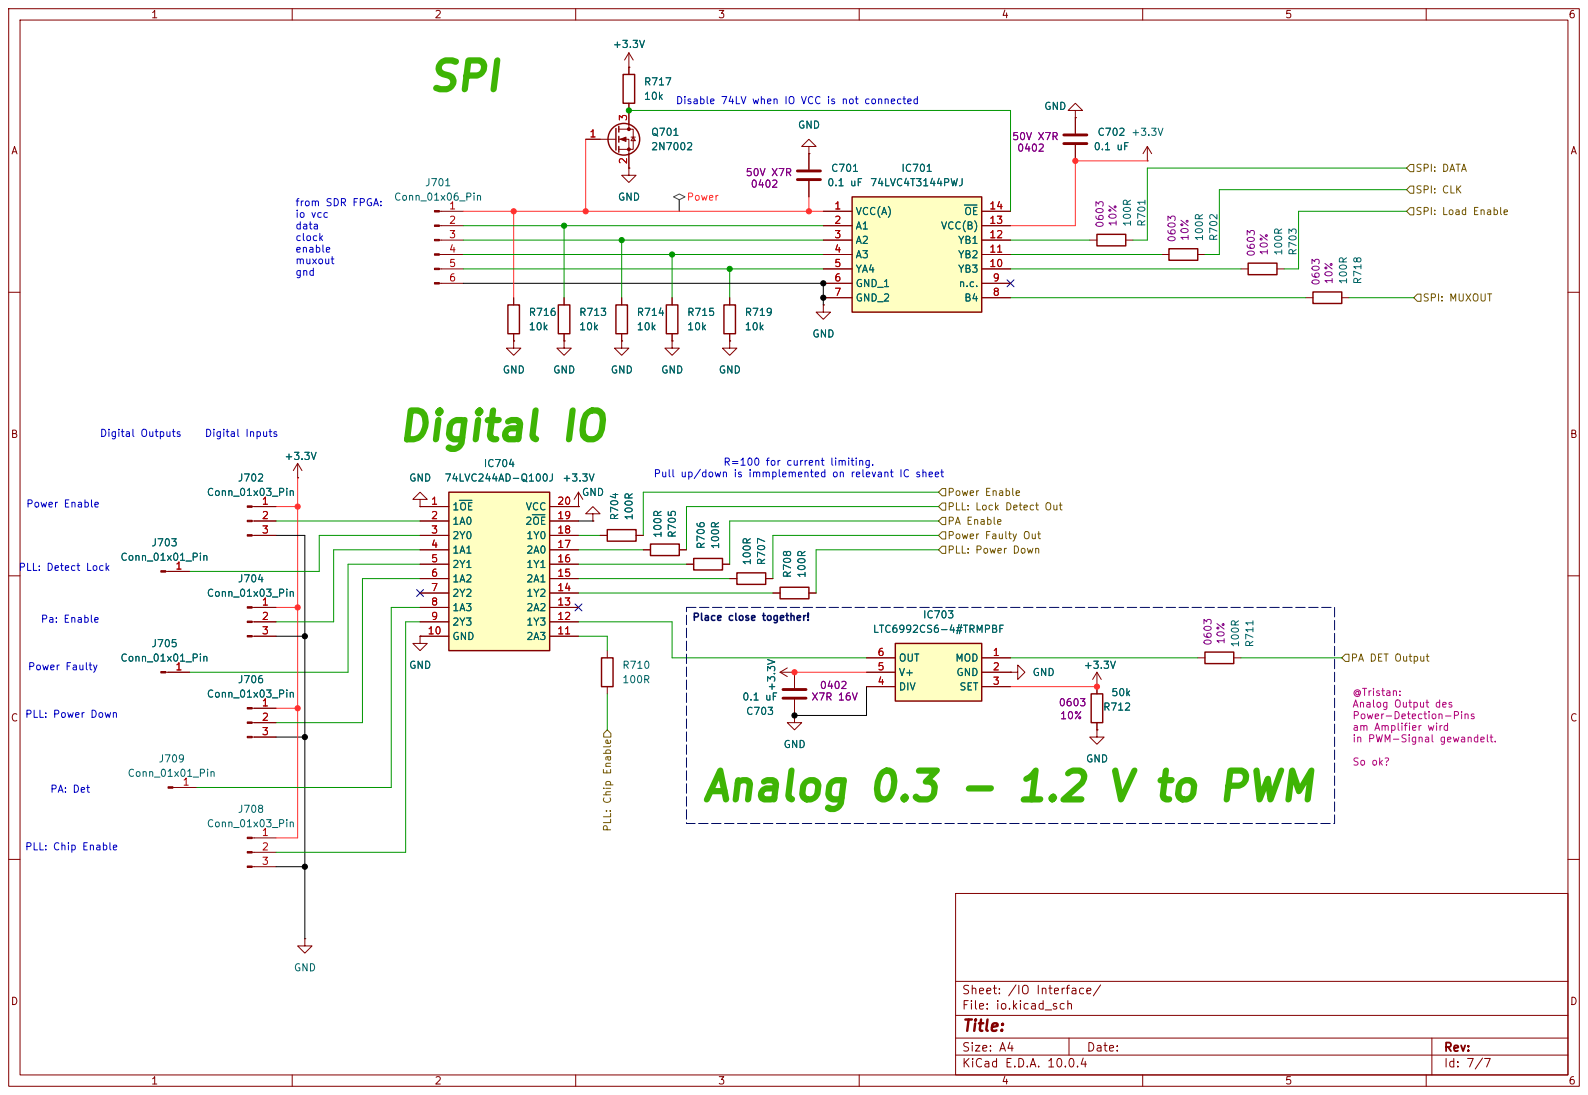
[picture p15: page 7]

Disable 74LV when IO VCC is not connected PLL: Power Down

Digital Outputs Power Faulty

Analog Output des Power-Detection-Pins am Amplifier wird

in PWM-Signal gewandelt. So ok? Analog 0.3 - 1.2 V to PWM
