JaxRaffnix/sdr-analog-frontend/pcb/main_v2/main_v2.kicad_pcb

## KiCad design pcb/main_v2/main_v2.kicad_pcb (2026-08-19)

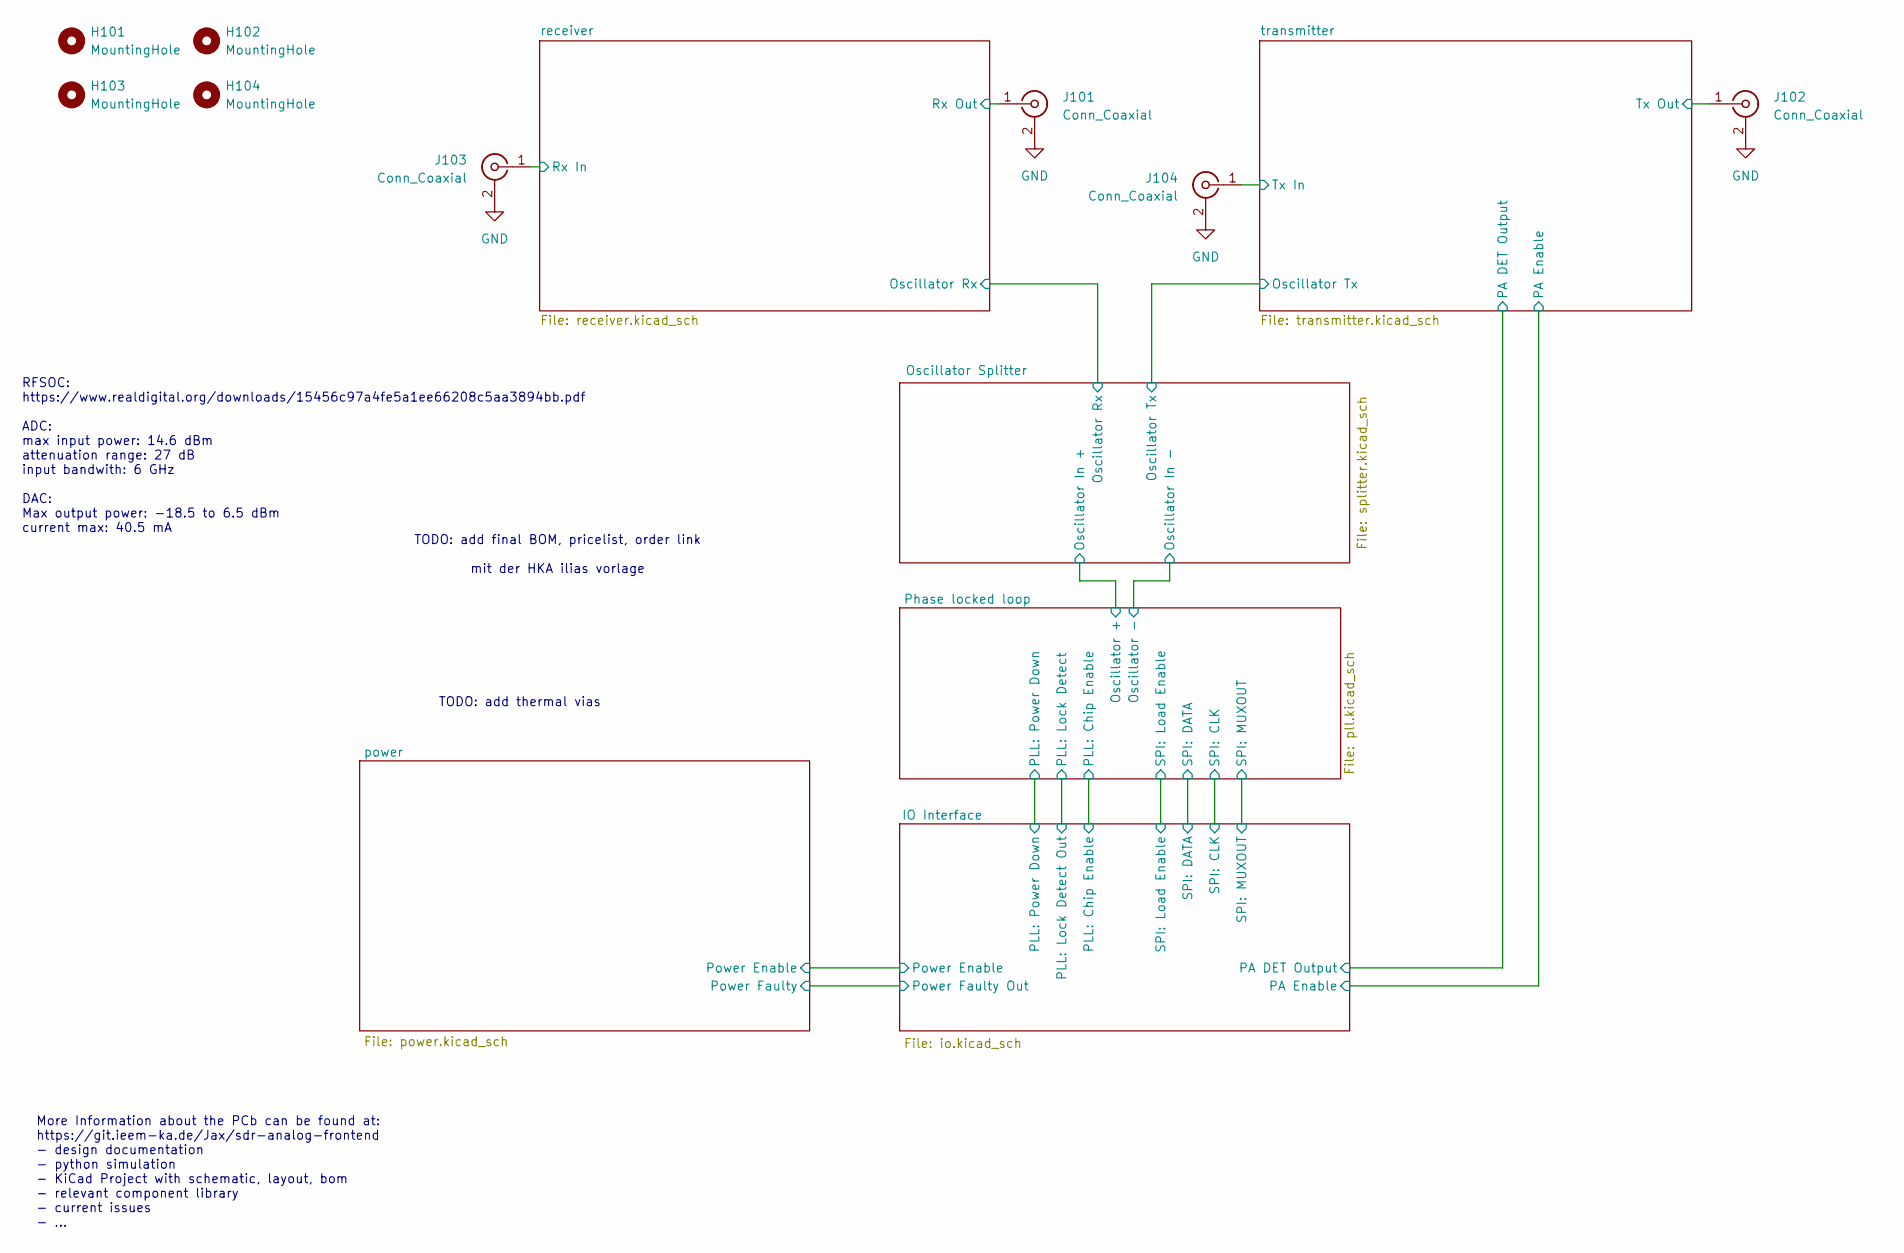
[picture p22: schematic main_v2.kicad_sch]

Parts:
H101, H102, H103, H104: MountingHole; MountingHole_2.2mm_M2
J101, J102, J103, J104: Conn_Coaxial; SMA_Amphenol_132289_EdgeMount

Connections:
/receiver/Rx In: J103.1 (In); also elsewhere on the board
/receiver/Rx Out: J101.1 (In); also elsewhere on the board
/transmitter/Tx In: J104.1 (In); also elsewhere on the board
/transmitter/Tx Out: J102.1 (In); also elsewhere on the board
GND: J101.2 (Ext), J102.2 (Ext), J103.2 (Ext), J104.2 (Ext); also elsewhere on the board

Notes on the sheet:
TODO: add final BOM, pricelist, order link mit der HKA ilias vorlage
TODO: add thermal vias
More Information about the PCb can be found at: https://git.ieem-ka.de/Jax/sdr-analog-frontend - design documentation - python simulation - KiCad Project with schematic, layout, bom - relevant component library - current issues - ...
RFSOC: https://www.realdigital.org/downloads/15456c97a4fe5a1ee66208c5aa3894bb.pdf ADC: max input power: 14.6 dBm attenuation range: 27 dB input bandwith: 6 GHz DAC: Max output power: -18.5 to 6.5 dBm current max: 40.5 mA

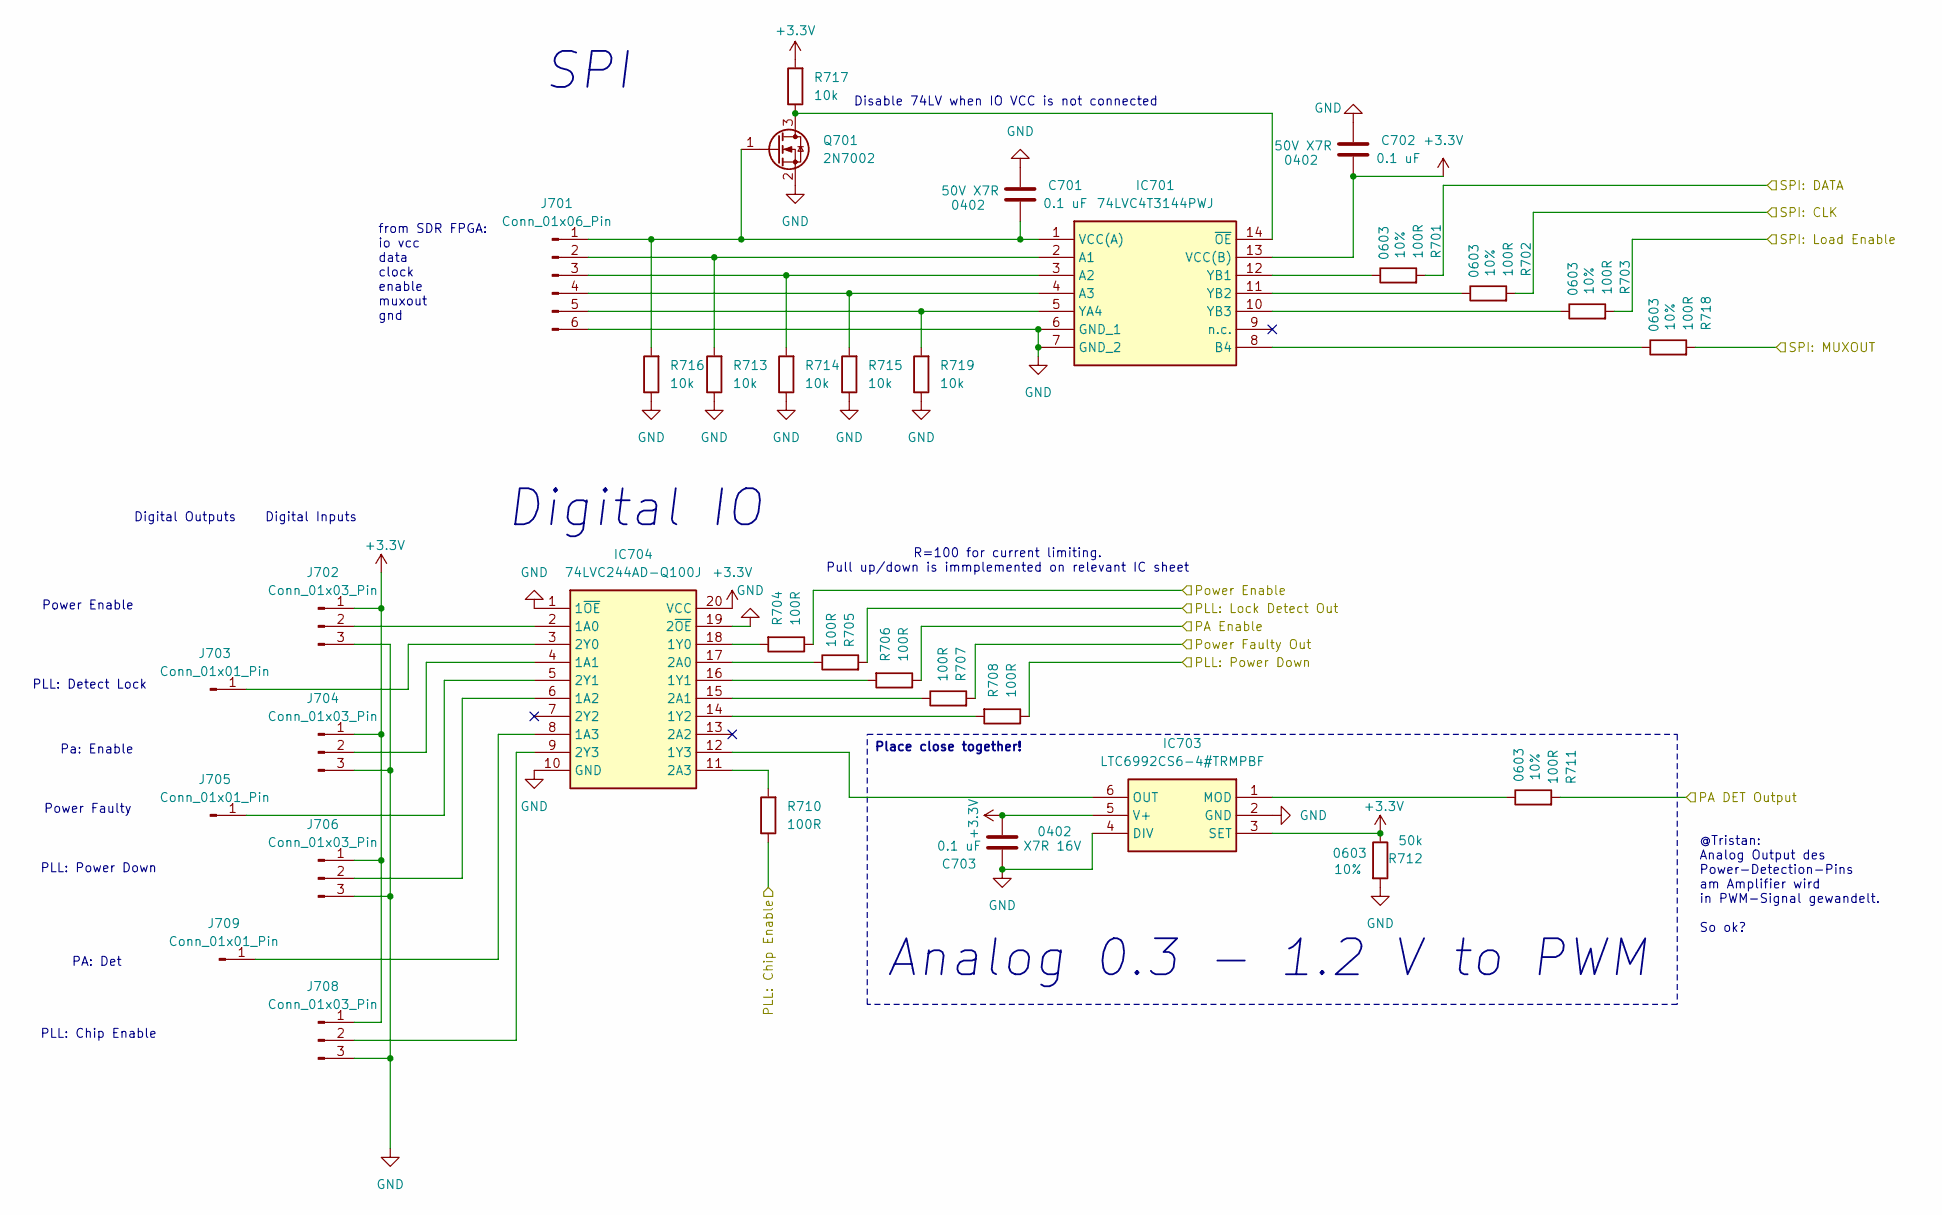
[picture p23: schematic io.kicad_sch]

Parts:
C701, C702: 0.1 uF; C_0402_1005Metric; Tolerance ±10%; Voltage 50V
C703: 0.1 uF; C_0402_1005Metric; Tolerance ±10%; Voltage 16V
IC701: 74LVC4T3144PWJ; SOP65P640X110-14N; Mouser Part Number 771-74LVC4T3144PWJ
IC703: LTC6992CS6-4#TRMPBF; SOT95P280X100-6N; Mouser Part Number 584-C6992CS6-4TRMPBF
IC704: 74LVC244AD-Q100J; SOIC127P1032X265-20N; Mouser Part Number 771-74LVC244AD-Q100J
J701: Conn_01x06_Pin; PinHeader_1x06_P2.54mm_Vertical
J702, J704, J706, J708: Conn_01x03_Pin; PinHeader_1x03_P2.54mm_Vertical
J703, J705, J709: Conn_01x01_Pin; PinHeader_1x01_P2.54mm_Vertical
Q701: 2N7002; SOT-23
R701, R702, R703, R711, R718: 100R; R_0603_1608Metric; Tolerance 10%
R704, R705, R706, R707, R708, R710: 100R; R_0603_1608Metric
R712: 50k; R_0603_1608Metric; Tolerance 10%
R713, R714, R715, R716, R717, R719: 10k; R_0603_1608Metric

Connections:
+3.3V: C702.1, C703.1, IC701.13 (VCC(B)), IC703.3 (SET), IC703.5 (V+), IC704.20 (VCC), J702.1, J704.1, J706.1, J708.1, R712.1, R717.2; also elsewhere on the board
/IO Interface/PA DET Output: R711.2; also elsewhere on the board
/IO Interface/PA Enable: R706.1; also elsewhere on the board
/IO Interface/PLL: Chip Enable: R710.1; also elsewhere on the board
/IO Interface/PLL: Lock Detect Out: R705.2; also elsewhere on the board
/IO Interface/PLL: Power Down: R708.1; also elsewhere on the board
/IO Interface/Power Enable: R704.1; also elsewhere on the board
/IO Interface/Power Faulty Out: R707.2; also elsewhere on the board
/IO Interface/SPI: CLK: R702.2; also elsewhere on the board
/IO Interface/SPI: DATA: R701.2; also elsewhere on the board
/IO Interface/SPI: Load Enable: R703.2; also elsewhere on the board
/IO Interface/SPI: MUXOUT: R718.2; also elsewhere on the board
GND: C701.2, C702.2, C703.2, IC701.6 (GND_1), IC701.7 (GND_2), IC703.2 (GND), IC703.4 (DIV), IC704.1 (1~OE), IC704.10 (GND), IC704.19 (2~OE), J701.6, J702.3, J704.3, J706.3, J708.3, Q701.2 (S), R712.2, R713.1, R714.1, R715.1, R716.1, R719.1; also elsewhere on the board
unnamed: IC701.2 (A1), J701.2, R713.2
unnamed: IC701.3 (A2), J701.3, R714.2
unnamed: IC701.4 (A3), J701.4, R715.2
unnamed: IC701.8 (B4), R718.1
unnamed: C701.1, IC701.1 (VCC(A)), J701.1, Q701.1 (G), R716.2
unnamed: IC701.5 (YA4), J701.5, R719.2
unnamed: IC701.12 (YB1), R701.1
unnamed: IC701.11 (YB2), R702.1
unnamed: IC701.10 (YB3), R703.1
unnamed: IC701.14 (~OE), Q701.3 (D), R717.1
unnamed: IC703.1 (MOD), R711.1
unnamed: IC703.6 (OUT), IC704.12 (1Y3)
unnamed: IC704.2 (1A0), J702.2
unnamed: IC704.4 (1A1), J704.2
unnamed: IC704.6 (1A2), J706.2
unnamed: IC704.8 (1A3), J709.1 (Pin_1_1)
unnamed: IC704.18 (1Y0), R704.2
unnamed: IC704.16 (1Y1), R706.2
unnamed: IC704.14 (1Y2), R708.2
unnamed: IC704.17 (2A0), R705.1
unnamed: IC704.15 (2A1), R707.1
unnamed: IC704.11 (2A3), R710.2
unnamed: IC704.3 (2Y0), J703.1 (Pin_1_1)
unnamed: IC704.5 (2Y1), J705.1 (Pin_1_1)
unnamed: IC704.9 (2Y3), J708.2

Notes on the sheet:
Power Enable
Analog 0.3 - 1.2 V to PWM
R=100 for current limiting. Pull up/down is immplemented on relevant IC sheet
PLL: Power Down
Digital IO
from SDR FPGA: io vcc data clock enable muxout gnd
Digital Inputs
PA: Det
Disable 74LV when IO VCC is not connected
Power Faulty
Digital Outputs
@Tristan: Analog Output des Power-Detection-Pins am Amplifier wird in PWM-Signal gewandelt. So ok?
PLL: Chip Enable
Pa: Enable
PLL: Detect Lock
SPI
Place close together!

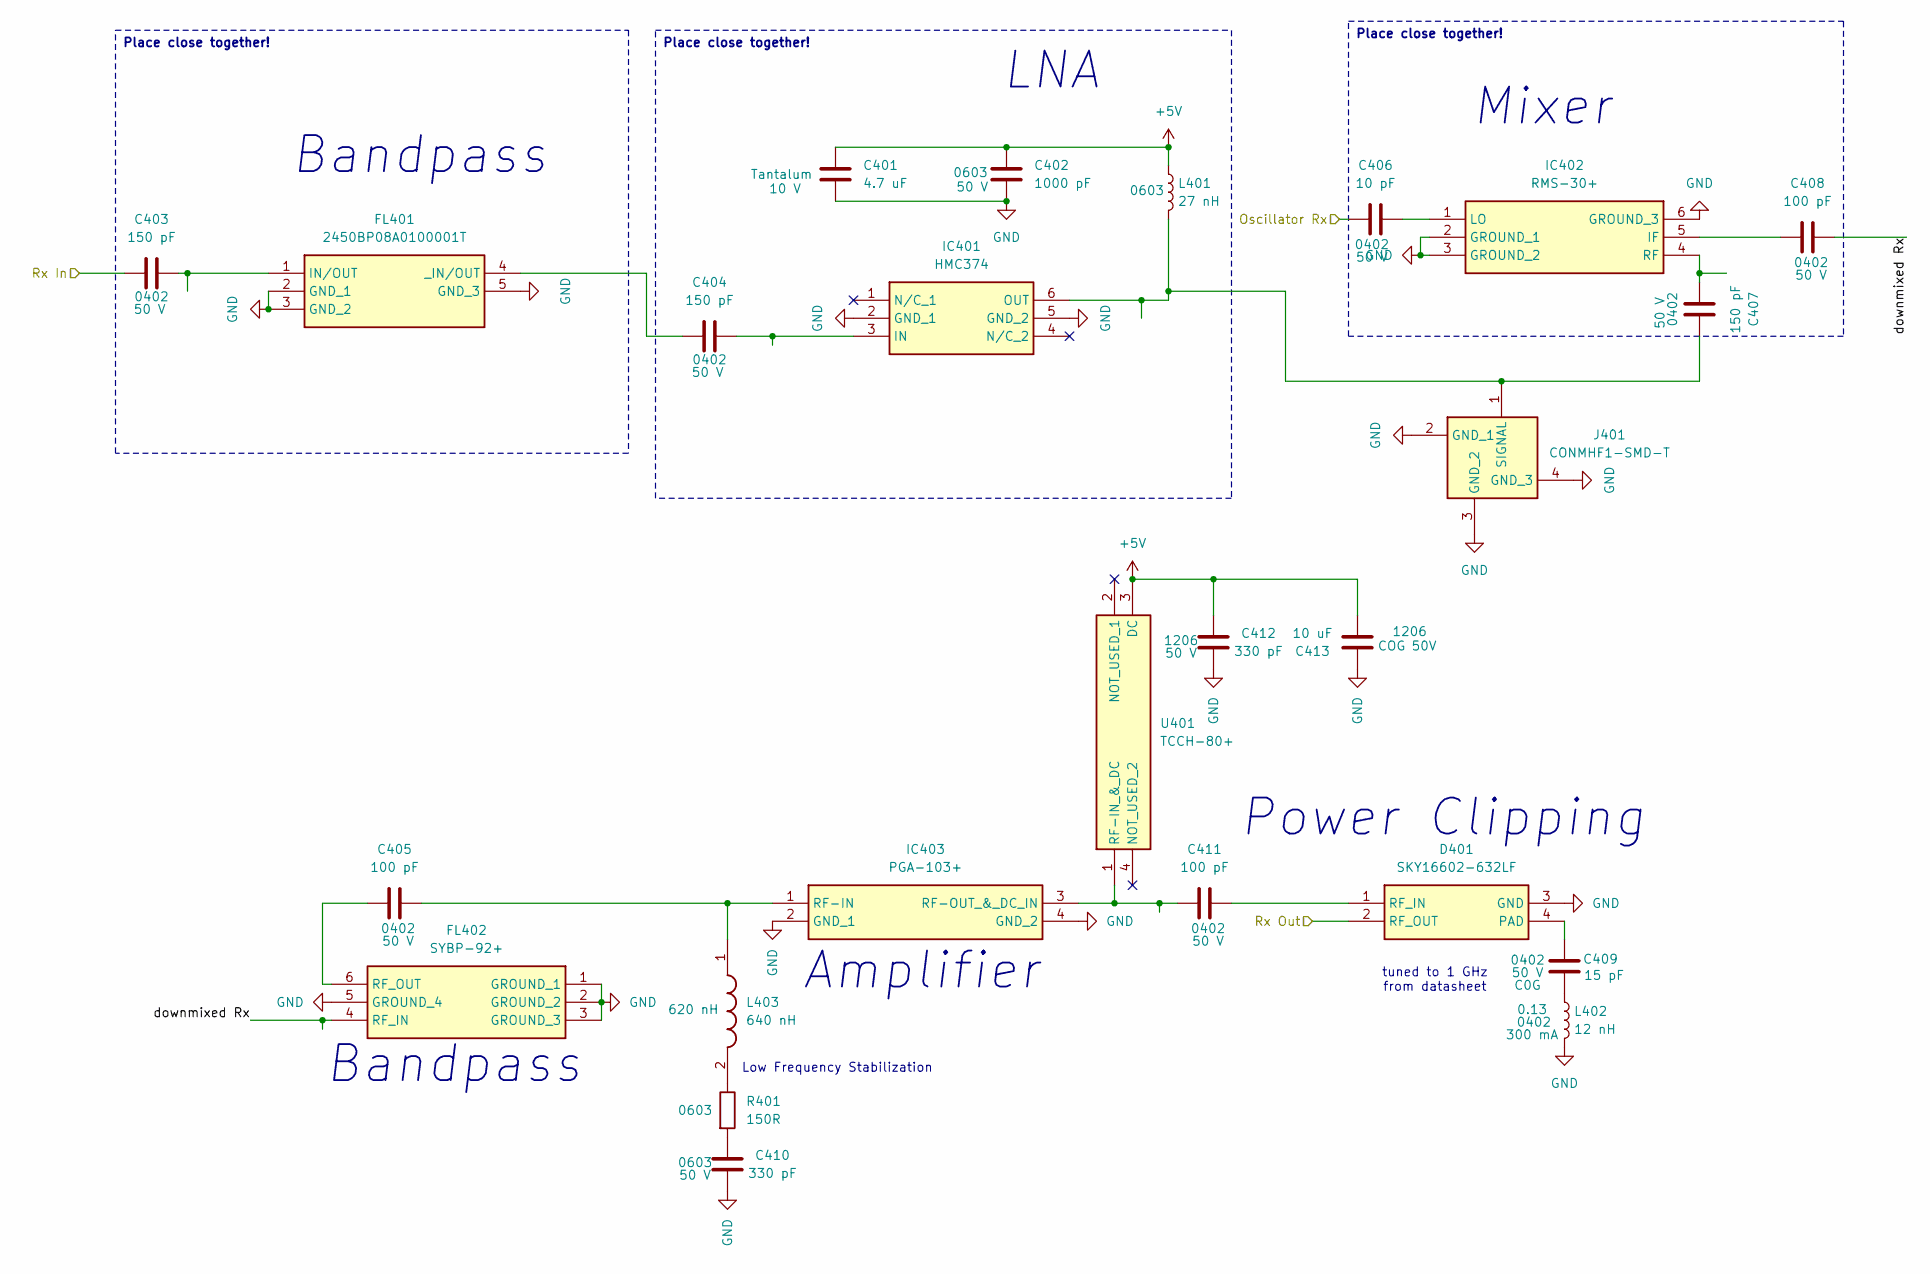
[picture p24: schematic receiver.kicad_sch]

Parts:
C401: 4.7 uF; CP_EIA-6032-20_AVX-F; Voltage 10 V
C402: 1000 pF; C_0603_1608Metric; Voltage 50 V
C403, C404, C407: 150 pF; C_0402_1005Metric; Voltage 50 V
C405, C408, C411: 100 pF; C_0402_1005Metric; Voltage 50 V
C406: 10 pF; C_0402_1005Metric; Voltage 50 V
C409: 15 pF; C_0402_1005Metric; Voltage 50 V
C410: 330 pF; C_0603_1608Metric; Voltage 50 V
C412: 330 pF; C_1206_3216Metric; Voltage 50 V
C413: 10 uF; C_1206_3216Metric; Tolerance ±10%; Voltage 50V
D401: SKY16602-632LF; SKY16602632LF; Mouser Part Number 873-SKY16602-632LF
FL401: 2450BP08A0100001T; Manufacturer_Part_Number 2450BP08A0100001T
FL402: SYBP-92+; SYBP92; Mouser Part Number 139-SYBP-92+
IC401: HMC374; SOT95P280X145-6N; Mouser Part Number 584-HMC374
IC402: RMS-30+; RMS30; Manufacturer_Part_Number RMS-30+
IC403: PGA-103+; GVA63; Mouser Part Number 139-PGA-103
J401: CONMHF1-SMD-T; CONMHF1SMDT; Mouser Part Number 712-CONMHF1-SMD-T
L401: 27 nH; L_0603_1608Metric
L402: 12 nH; L_0402_1005Metric
L403: 640 nH; L_0402_1005Metric
R401: 150R; R_0603_1608Metric; Tolerance 5%
U401: TCCH-80+; TCCH80; Mouser Part Number 139-TCCH-80

Connections:
+5V: C401.1, C402.2, C412.1, C413.1, L401.1, U401.3 (DC); also elsewhere on the board
/Oscillator Splitter/Oscillator Rx: C406.2; also elsewhere on the board
/receiver/Rx In: C403.1; also elsewhere on the board
/receiver/Rx Out: D401.2 (RF_OUT); also elsewhere on the board
/receiver/downmixed Rx: C408.2, FL402.4 (RF_IN)
GND: C401.2, C402.1, C410.2, C412.2, C413.2, D401.3 (GND), FL401.2 (GND_1), FL401.3 (GND_2), FL401.5 (GND_3), FL402.1 (GROUND_1), FL402.2 (GROUND_2), FL402.3 (GROUND_3), FL402.5 (GROUND_4), IC401.2 (GND_1), IC401.5 (GND_2), IC402.2 (GROUND_1), IC402.3 (GROUND_2), IC402.6 (GROUND_3), IC403.2 (GND_1), IC403.4 (GND_2), J401.2 (GND_1), J401.3 (GND_2), J401.4 (GND_3), L402.2; also elsewhere on the board
unnamed: C409.2, L402.1
unnamed: C410.1, R401.2
unnamed: C409.1, D401.4 (PAD)
unnamed: C411.2, D401.1 (RF_IN)
unnamed: C403.2, FL401.1 (IN/OUT)
unnamed: C404.1, FL401.4 (_IN/OUT)
unnamed: C405.1, FL402.6 (RF_OUT)
unnamed: C404.2, IC401.3 (IN)
unnamed: C407.2, IC401.6 (OUT), J401.1 (SIGNAL), L401.2
unnamed: C408.1, IC402.5 (IF)
unnamed: C406.1, IC402.1 (LO)
unnamed: C407.1, IC402.4 (RF)
unnamed: C405.2, IC403.1 (RF-IN), L403.1
unnamed: C411.1, IC403.3 (RF-OUT_&_DC_IN), U401.1 (RF-IN_&_DC)
unnamed: L403.2, R401.1

Notes on the sheet:
Low Frequency Stabilization
Bandpass
Amplifier
LNA
Power Clipping
tuned to 1 GHz from datasheet
Mixer
Place close together!

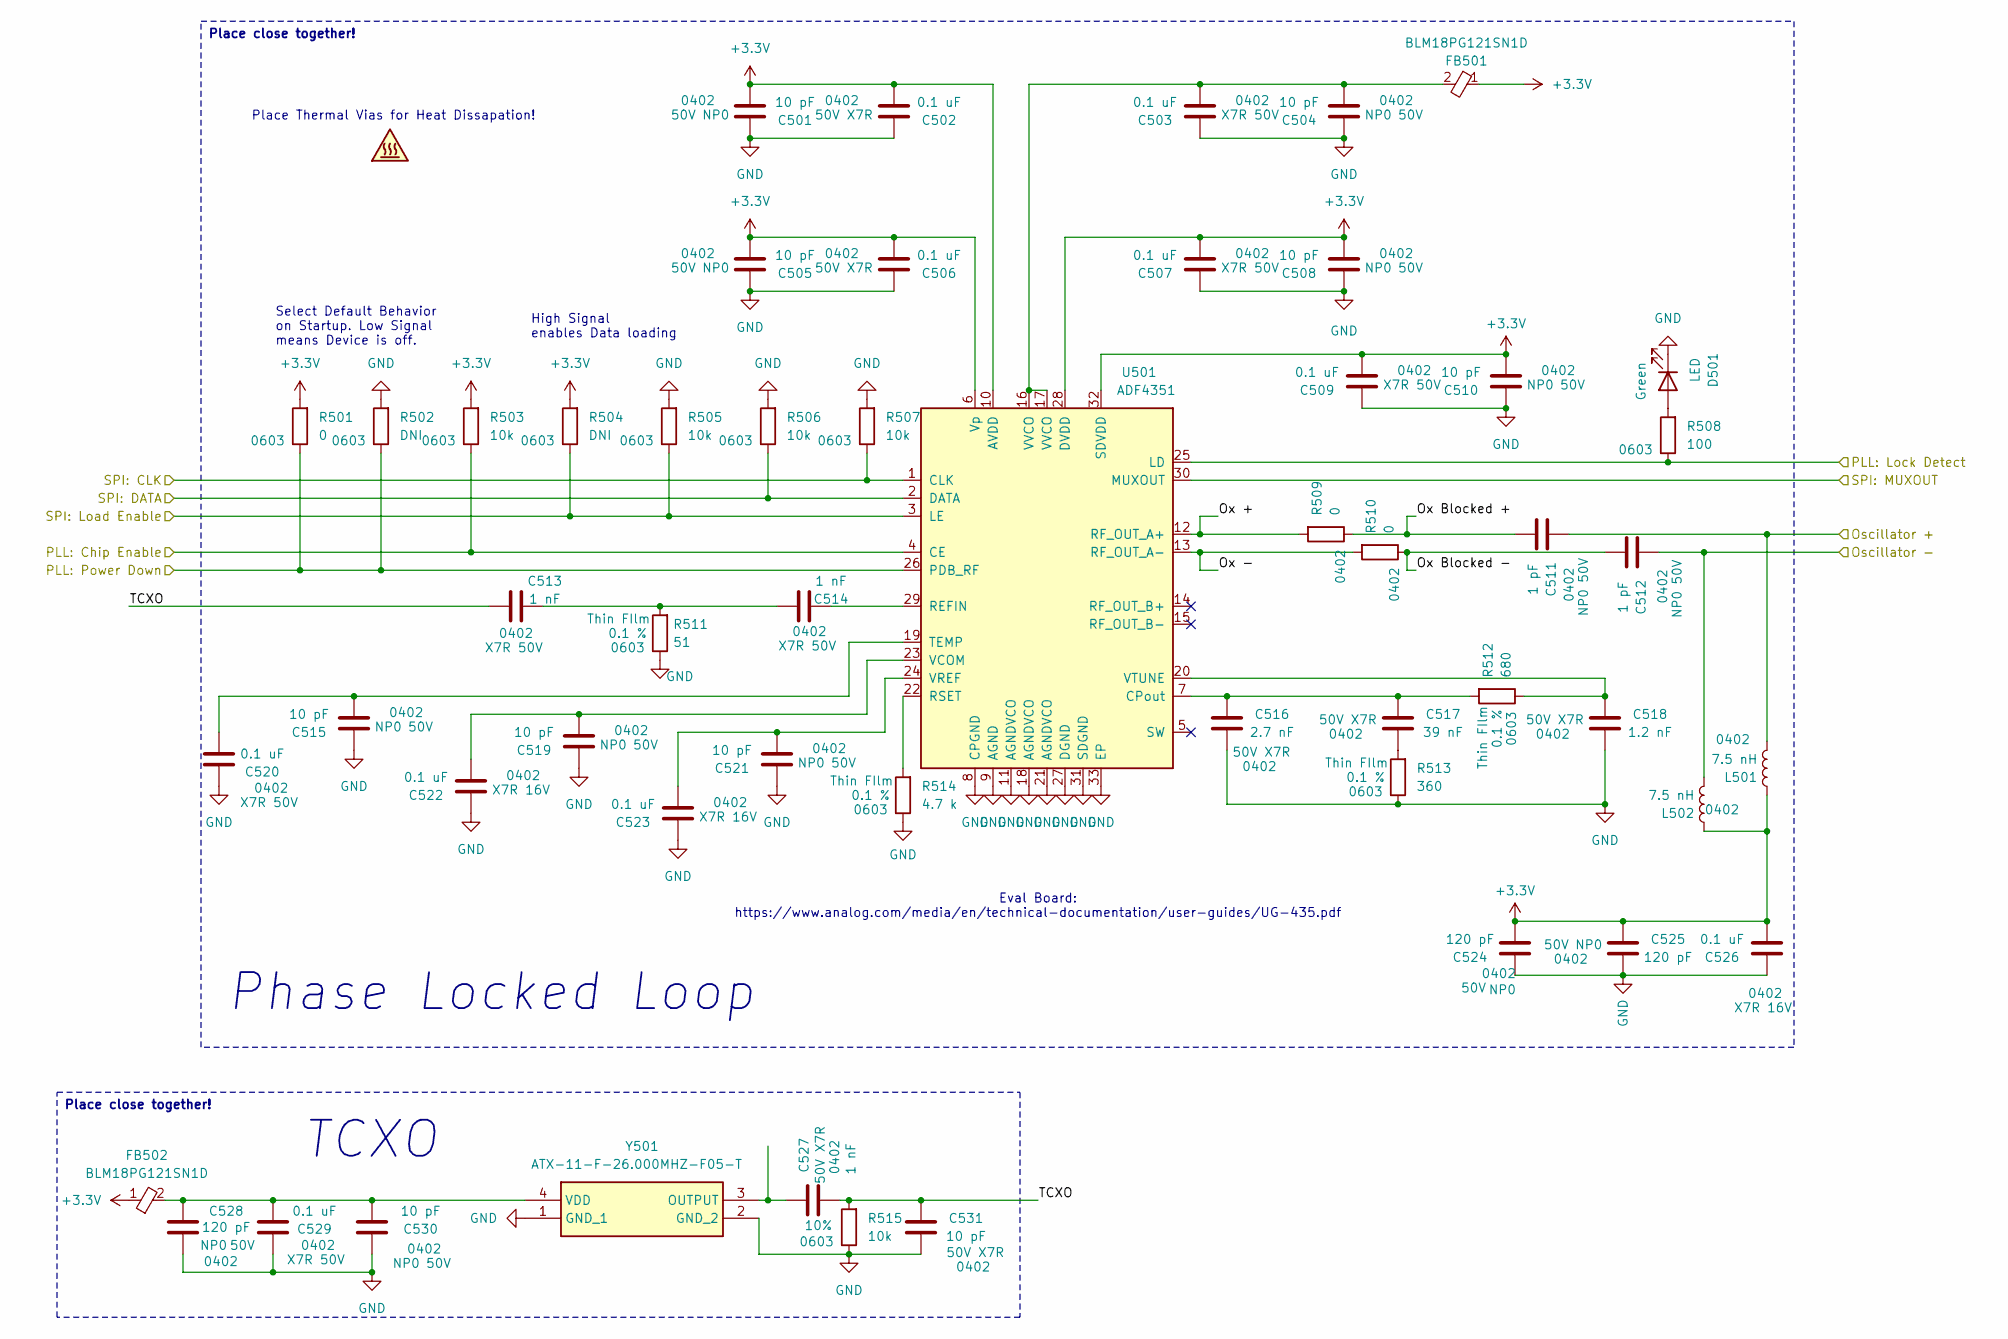
[picture p25: schematic pll.kicad_sch]

Parts:
C501, C504, C505, C508, C510, C515, C519, C521, C530, C531: 10 pF; C_0402_1005Metric; Tolerance ±10%; Voltage 50V
C502, C503, C506, C507, C509, C520, C529: 0.1 uF; C_0402_1005Metric; Tolerance ±10%; Voltage 50V
C511, C512: 1 pF; C_0402_1005Metric; Tolerance ±10%; Voltage 50V
C513, C514, C527: 1 nF; C_0402_1005Metric; Tolerance ±10%; Voltage 50V
C516: 2.7 nF; C_0402_1005Metric; Tolerance ±10%; Voltage 50V
C517: 39 nF; C_0402_1005Metric; Tolerance ±10%; Voltage 50V
C518: 1.2 nF; C_0402_1005Metric; Tolerance ±10%; Voltage 50V
C522, C523, C526: 0.1 uF; C_0402_1005Metric; Tolerance ±10%; Voltage 16V
C524, C525, C528: 120 pF; C_0402_1005Metric; Tolerance ±10%; Voltage 50V
D501: LED; LED_0805_2012Metric
FB501, FB502: BLM18PG121SN1D; BLM18SP221SN1B; Mouser Part Number 81-BLM18PG121SN1D
L501, L502: 7.5 nH; L_0402_1005Metric
R501, R509, R510: 0; R_0603_1608Metric
R502, R504: DNI; R_0603_1608Metric
R503, R505, R506, R507: 10k; R_0603_1608Metric
R508: 100; R_0603_1608Metric
R511: 51; R_0603_1608Metric; Tolerance 0.1 %
R512: 680; R_0603_1608Metric; Tolerance 0.1 %
R513: 360; R_0603_1608Metric; Tolerance 0.1 %
R514: 4.7 k; R_0603_1608Metric; Tolerance 0.1 %
R515: 10k; R_0603_1608Metric; Tolerance 10%
U501: ADF4351; LFCSP-32-1EP_5x5mm_P0.5mm_EP3.25x3.25mm
Y501: ATX-11-F-26.000MHZ-F05-T; ATX11F26000MHZF05T; Manufacturer_Part_Number ATX-11-F-26.000MHZ-F05-T

Connections:
+3.3V: C501.1, C502.1, C505.1, C506.1, C507.1, C508.1, C509.1, C510.1, C524.1, C525.2, C526.1, FB501.1, FB502.1, L501.1, L502.1, R501.2, R503.2, R504.2, U501.6 (Vp), U501.10 (AVDD), U501.28 (DVDD), U501.32 (SDVDD); also elsewhere on the board
/IO Interface/PLL: Chip Enable: R503.1, U501.4 (CE); also elsewhere on the board
/IO Interface/PLL: Lock Detect Out: R508.1, U501.25 (LD); also elsewhere on the board
/IO Interface/PLL: Power Down: R501.1, R502.1, U501.26 (PDB_RF); also elsewhere on the board
/IO Interface/SPI: CLK: R507.1, U501.1 (CLK); also elsewhere on the board
/IO Interface/SPI: DATA: R506.1, U501.2 (DATA); also elsewhere on the board
/IO Interface/SPI: Load Enable: R504.1, R505.1, U501.3 (LE); also elsewhere on the board
/IO Interface/SPI: MUXOUT: U501.30 (MUXOUT); also elsewhere on the board
/Oscillator Splitter/Oscillator In +: C511.2, L501.2; also elsewhere on the board
/Oscillator Splitter/Oscillator In -: C512.2, L502.2; also elsewhere on the board
/Phase locked loop/Ox +: R509.2, U501.12 (RF_OUT_A+)
/Phase locked loop/Ox -: R510.2, U501.13 (RF_OUT_A-)
/Phase locked loop/Ox Blocked +: C511.1, R509.1
/Phase locked loop/Ox Blocked -: C512.1, R510.1
/Phase locked loop/TCXO: C513.2, C527.1, C531.2, R515.2
GND: C501.2, C502.2, C503.2, C504.2, C505.2, C506.2, C507.2, C508.2, C509.2, C510.2, C515.2, C516.1, C518.1, C519.2, C520.2, C521.2, C522.2, C523.2, C524.2, C525.1, C526.2, C528.1, C529.2, C530.2, C531.1, D501.1 (K), R502.2, R505.2, R506.2, R507.2, R511.1, R513.1, R514.1, R515.1, U501.8 (CPGND), U501.9 (AGND), U501.11 (AGNDVCO), U501.18 (AGNDVCO), U501.21 (AGNDVCO), U501.27 (DGND), U501.31 (SDGND), U501.33 (EP), Y501.1 (GND_1), Y501.2 (GND_2); also elsewhere on the board
unnamed: C503.1, C504.1, FB501.2, U501.16 (VVCO), U501.17 (VVCO)
unnamed: C513.1, C514.2, R511.2
unnamed: C517.1, R513.2
unnamed: D501.2 (A), R508.2
unnamed: C516.2, C517.2, R512.2, U501.7 (CPout)
unnamed: C514.1, U501.29 (REFIN)
unnamed: R514.2, U501.22 (RSET)
unnamed: C515.1, C520.1, U501.19 (TEMP)
unnamed: C519.1, C522.1, U501.23 (VCOM)
unnamed: C521.1, C523.1, U501.24 (VREF)
unnamed: C518.2, R512.1, U501.20 (VTUNE)
unnamed: C527.2, Y501.3 (OUTPUT)
unnamed: C528.2, C529.1, C530.1, FB502.2, Y501.4 (VDD)

Notes on the sheet:
TCXO
Eval Board: https://www.analog.com/media/en/technical-documentation/user-guides/UG-435.pdf
Select Default Behavior on Startup. Low Signal means Device is off.
Place Thermal Vias for Heat Dissapation!
High Signal enables Data loading
Phase Locked Loop
Place close together!

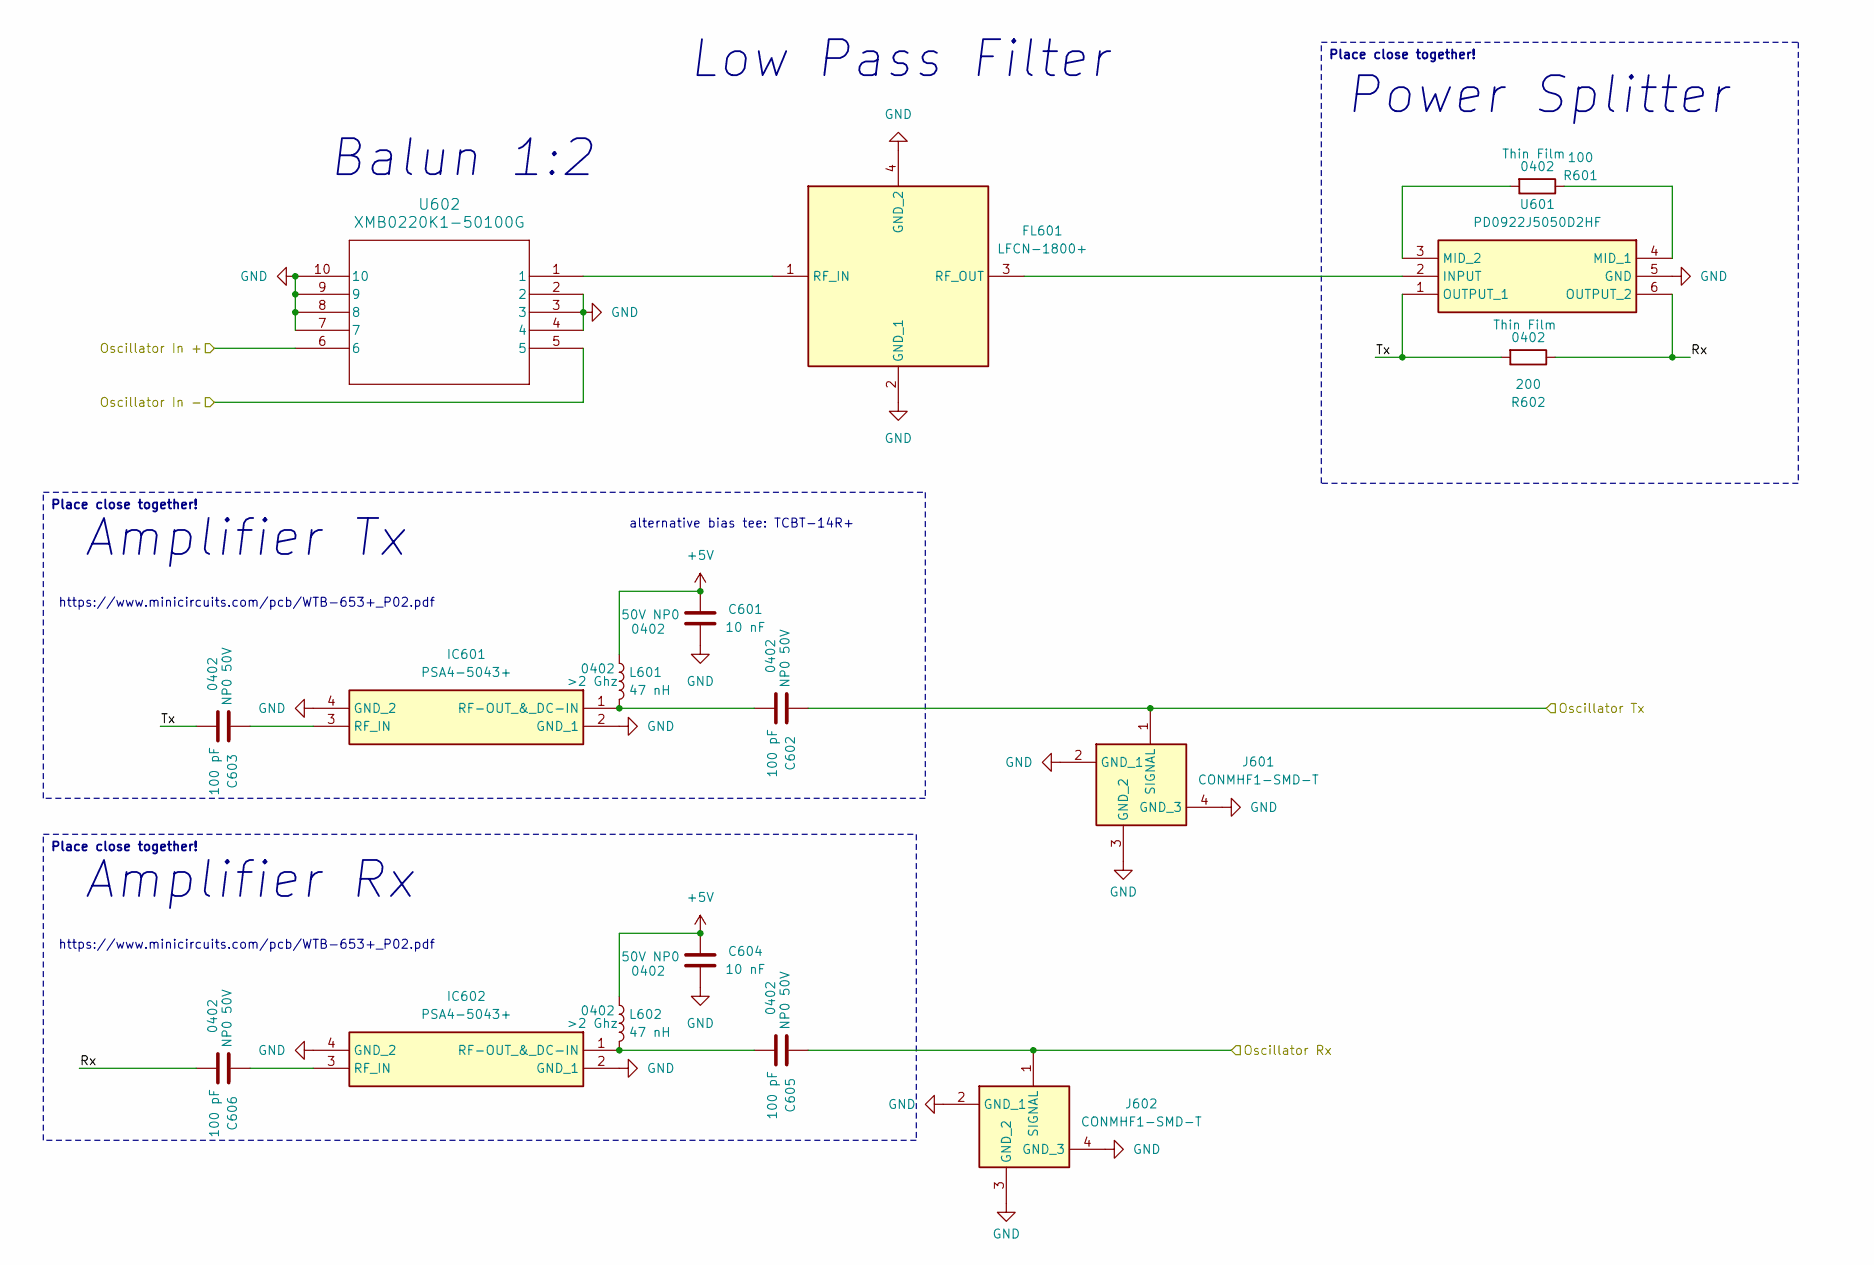
[picture p26: schematic splitter.kicad_sch]

Parts:
C601, C604: 10 nF; C_0402_1005Metric; Tolerance ±10%; Voltage 50V
C602, C603, C605, C606: 100 pF; C_0402_1005Metric; Tolerance ±10%; Voltage 50V
FL601: LFCN-1800+; LFCN1800; Mouser Part Number 139-LFCN-1800
IC601, IC602: PSA4-5043+; PSA45043; Mouser Part Number 139-PSA4-5043
J601, J602: CONMHF1-SMD-T; CONMHF1SMDT; Mouser Part Number 712-CONMHF1-SMD-T
L601, L602: 47 nH; L_0402_1005Metric
R601: 100; R_0402_1005Metric
R602: 200; R_0402_1005Metric
U601: PD0922J5050D2HF; Mouser Part Number 620-PD0922J5050D2HF
U602: XMB0220K1-50100G; XMB0220K1-50100G_TTT

Connections:
+5V: C601.2, C604.2, L601.1, L602.1; also elsewhere on the board
/Oscillator Splitter/Oscillator In +: U602.6; also elsewhere on the board
/Oscillator Splitter/Oscillator In -: U602.5; also elsewhere on the board
/Oscillator Splitter/Oscillator Rx: C605.2, J602.1 (SIGNAL); also elsewhere on the board
/Oscillator Splitter/Oscillator Tx: C602.2, J601.1 (SIGNAL); also elsewhere on the board
/Oscillator Splitter/Rx: C606.1, R602.1, U601.6 (OUTPUT_2)
/Oscillator Splitter/Tx: C603.1, R602.2, U601.1 (OUTPUT_1)
GND: C601.1, C604.1, FL601.2 (GND_1), FL601.4 (GND_2), IC601.2 (GND_1), IC601.4 (GND_2), IC602.2 (GND_1), IC602.4 (GND_2), J601.2 (GND_1), J601.3 (GND_2), J601.4 (GND_3), J602.2 (GND_1), J602.3 (GND_2), J602.4 (GND_3), U601.5 (GND), U602.2, U602.3, U602.4, U602.7, U602.8, U602.9, U602.10; also elsewhere on the board
unnamed: FL601.1 (RF_IN), U602.1
unnamed: FL601.3 (RF_OUT), U601.2 (INPUT)
unnamed: C602.1, IC601.1 (RF-OUT_&_DC-IN), L601.2
unnamed: C603.2, IC601.3 (RF_IN)
unnamed: C605.1, IC602.1 (RF-OUT_&_DC-IN), L602.2
unnamed: C606.2, IC602.3 (RF_IN)
unnamed: R601.1, U601.4 (MID_1)
unnamed: R601.2, U601.3 (MID_2)

Notes on the sheet:
Low Pass Filter
Power Splitter
https://www.minicircuits.com/pcb/WTB-653+_P02.pdf
Balun 1:2
Amplifier Rx
alternative bias tee: TCBT-14R+
Amplifier Tx
Place close together!
