JaxRaffnix/sdr-analog-frontend/pcb/main_v2/main_v2.kicad_pcb

## KiCad design pcb/main_v2/main_v2.kicad_pcb (continued)

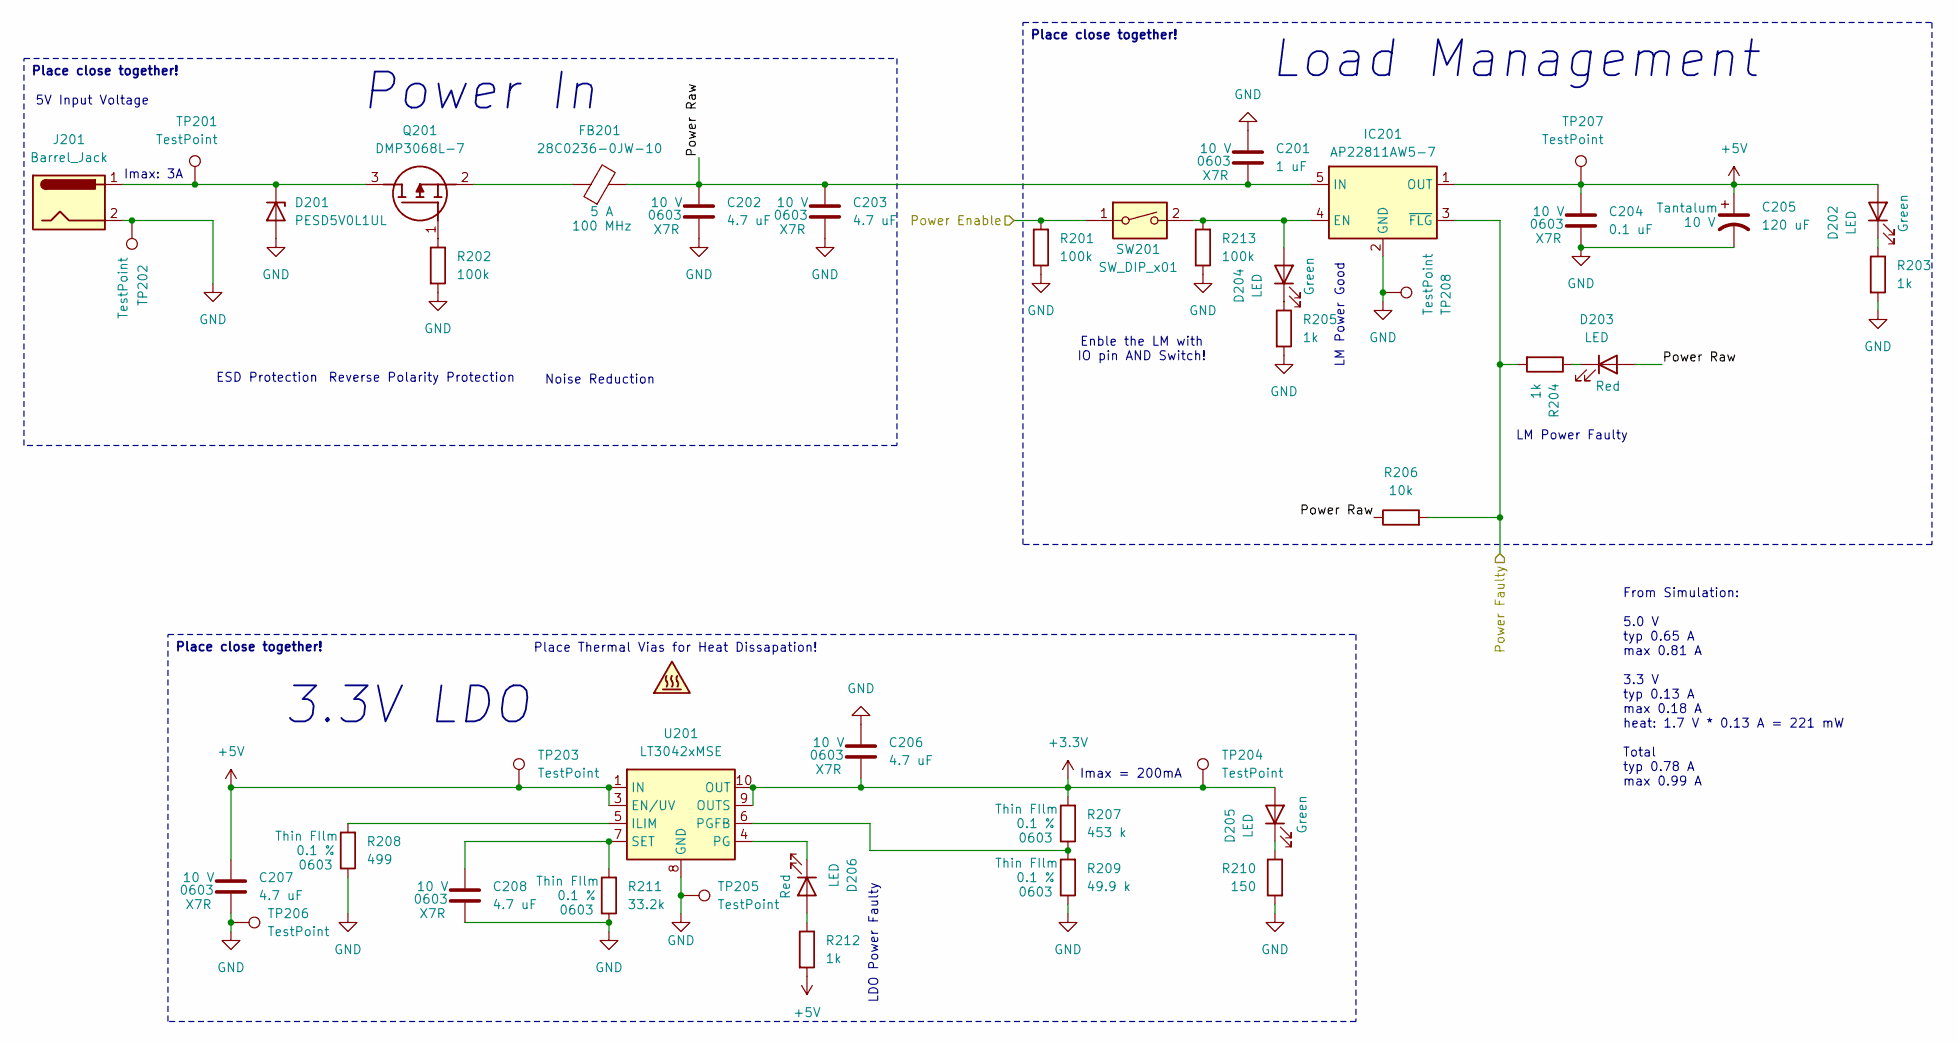
[picture p27: schematic power.kicad_sch]

Parts:
C201: 1 uF; C_0603_1608Metric; Voltage 10 V
C202, C203, C206, C207, C208: 4.7 uF; C_0603_1608Metric; Voltage 10 V
C204: 0.1 uF; C_0603_1608Metric; Voltage 10 V
C205: 120 uF; CP_EIA-6032-20_AVX-F; Voltage 10 V
D201: PESD5V0L1UL; D_SOD-882
D202, D203, D204, D205, D206: LED; LED_0805_2012Metric
FB201: 28C0236-0JW-10; LairdTech_28C0236-0JW-10
IC201: AP22811AW5-7; SOT-23-5; Mouser Part Number 621-AP22811AW5-7
J201: Barrel_Jack; BarrelJack_CUI_PJ-063AH_Horizontal_CircularHoles
Q201: DMP3068L-7; SOT96P240X115-3N; Mouser Part Number 621-DMP3068L-7
R201, R202, R213: 100k; R_0603_1608Metric
R203, R204, R205, R212: 1k; R_0603_1608Metric
R206: 10k; R_0603_1608Metric
R207: 453 k; R_0603_1608Metric; Tolerance 0.1 %
R208: 499; R_0603_1608Metric; Tolerance 0.1 %
R209: 49.9 k; R_0603_1608Metric; Tolerance 0.1 %
R210: 150; R_0603_1608Metric
R211: 33.2k; R_0603_1608Metric; Tolerance 0.1 %
SW201: SW_DIP_x01; SW_DIP_SPSTx01_Slide_6.7x4.1mm_W6.73mm_P2.54mm_LowProfile_J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
TP201, TP202, TP203, TP204, TP205, TP206, TP207, TP208: TestPoint; TestPoint_Pad_D1.0mm
U201: LT3042xMSE; MSOP-10-1EP_3x3mm_P0.5mm_EP1.68x1.88mm

Connections:
+3.3V: C206.2, D205.2 (A), R207.2, TP204.1 (1_1), U201.9 (OUTS), U201.10 (OUT); also elsewhere on the board
+5V: C204.1, C205.1, C207.1, D202.2 (A), IC201.1 (OUT), R212.2, TP203.1 (1_1), TP207.1 (1_1), U201.1 (IN), U201.2 (IN), U201.3 (EN/UV); also elsewhere on the board
/IO Interface/Power Enable: R201.2, SW201.1; also elsewhere on the board
/IO Interface/Power Faulty Out: IC201.3 (~FLG), R204.2, R206.2; also elsewhere on the board
/power/Power Raw: C201.2, C202.1, C203.1, D203.2 (A), FB201.2, IC201.5 (IN), R206.1
GND: C201.1, C202.2, C203.2, C204.2, C205.2, C206.1, C207.2, C208.2, D201.2 (A), IC201.2 (GND), J201.2, R201.1, R202.2, R203.2, R205.2, R208.1, R209.1, R210.2, R211.1, R213.1, TP202.1 (1_1), TP205.1 (1_1), TP206.1 (1_1), TP208.1 (1_1), U201.8 (GND), U201.11 (GND); also elsewhere on the board
unnamed: D201.1 (K), J201.1, Q201.3 (D), TP201.1 (1_1)
unnamed: D202.1 (K), R203.1
unnamed: D203.1 (K), R204.1
unnamed: D204.2 (A), IC201.4 (EN), R213.2, SW201.2
unnamed: D204.1 (K), R205.1
unnamed: D205.1 (K), R210.1
unnamed: D206.2 (A), R212.1
unnamed: D206.1 (K), U201.4 (PG)
unnamed: Q201.1 (G), R202.1
unnamed: FB201.1, Q201.2 (S)
unnamed: R208.2, U201.5 (ILIM)
unnamed: R207.1, R209.2, U201.6 (PGFB)
unnamed: C208.1, R211.2, U201.7 (SET)

Notes on the sheet:
Power In
From Simulation: 5.0 V typ 0.65 A max 0.81 A 3.3 V typ 0.13 A max 0.18 A heat: 1.7 V * 0.13 A = 221 mW Total typ 0.78 A max 0.99 A
ESD Protection
LM Power Faulty
Load Management
Imax = 200mA
3.3V LDO
LDO Power Faulty
Imax: 3A
LM Power Good
Reverse Polarity Protection
Enble the LM with IO pin AND Switch!
Place Thermal Vias for Heat Dissapation!
Noise Reduction
5V Input Voltage
Place close together!

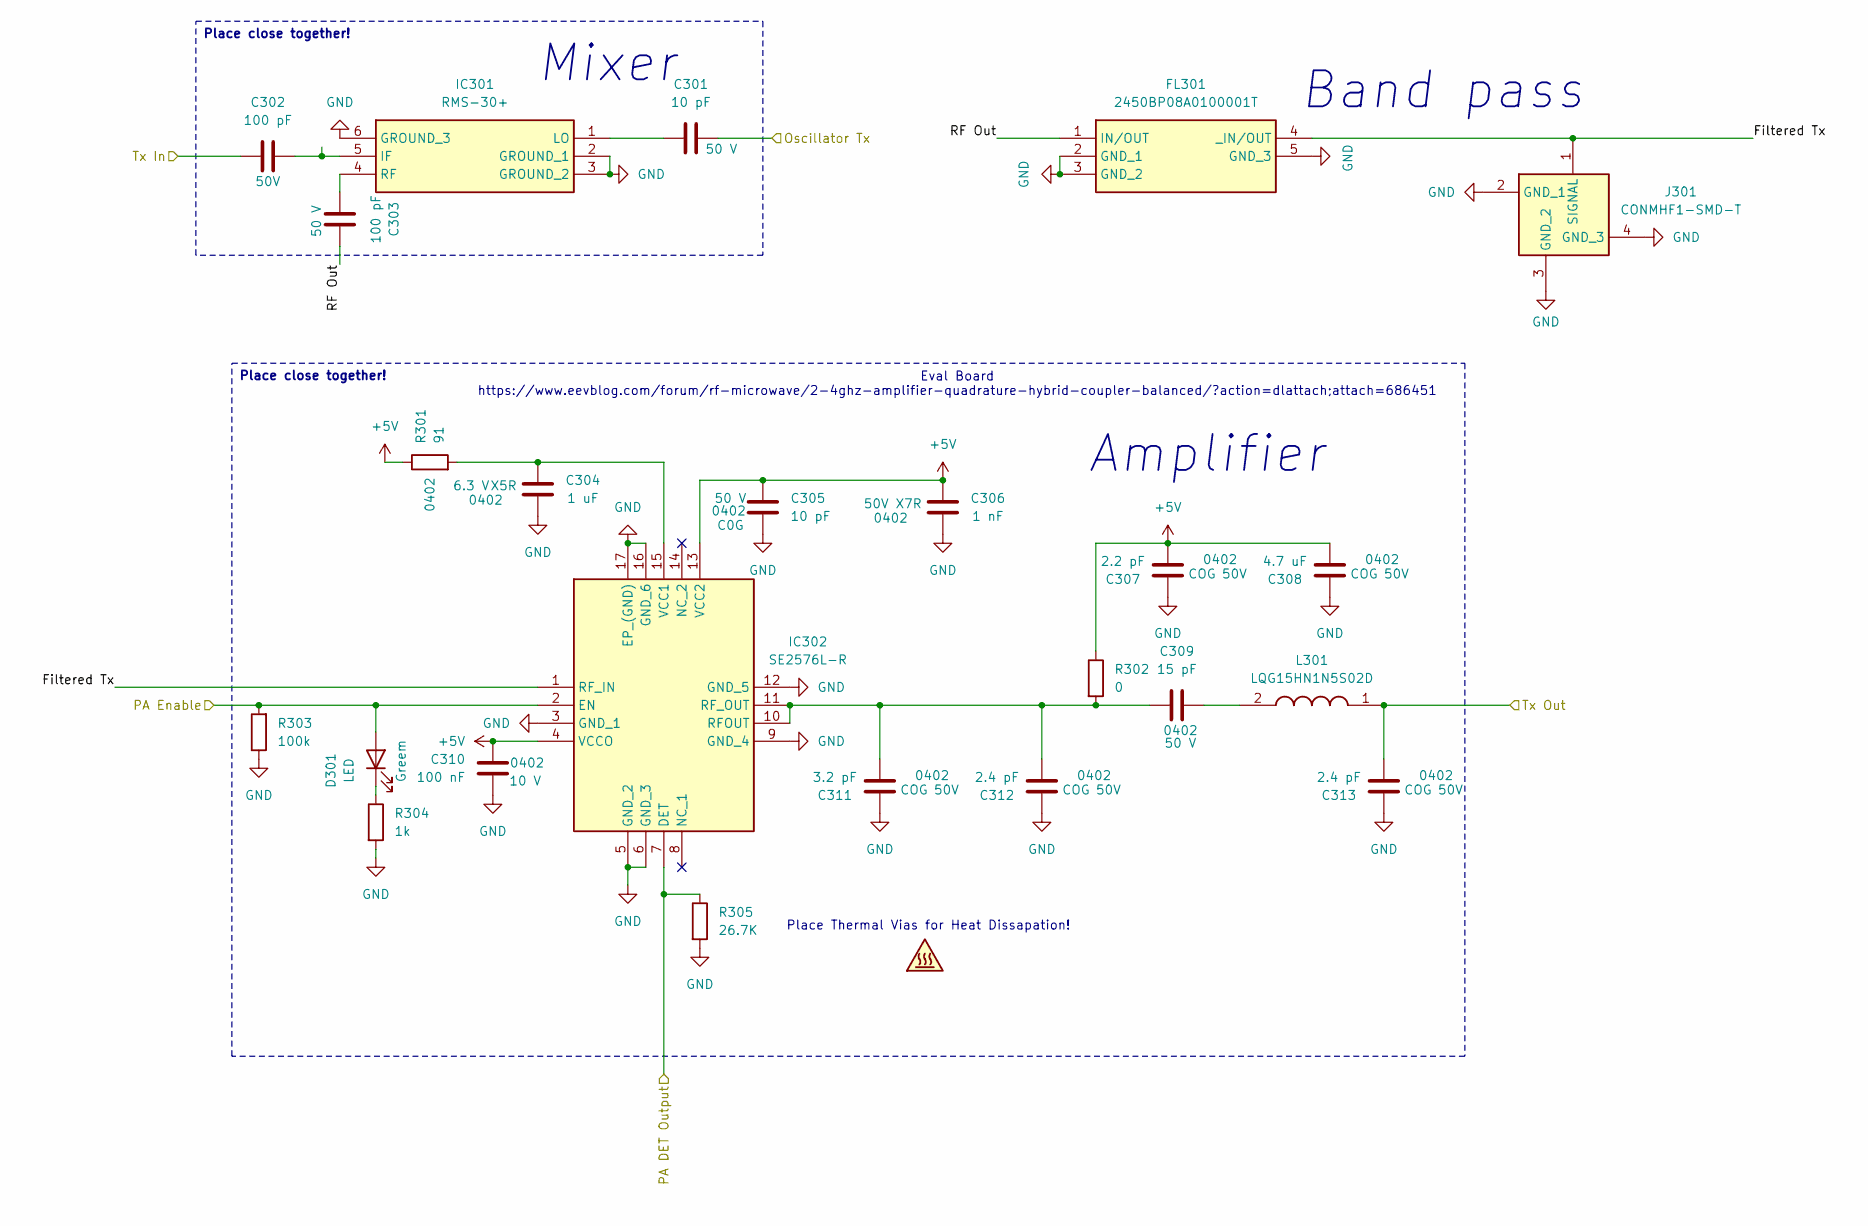
[picture p28: schematic transmitter.kicad_sch]

Parts:
C301, C305: 10 pF; C_0402_1005Metric; Voltage 50 V
C302: 100 pF; C_0402_1005Metric; Voltage 50V
C303: 100 pF; C_0402_1005Metric; Voltage 50 V
C304: 1 uF; C_0402_1005Metric; Tolerance 10 %; Voltage 6.3 V
C306: 1 nF; C_0402_1005Metric; Tolerance ±10%; Voltage 50V
C307: 2.2 pF; C_0402_1005Metric; Tolerance ±10%; Voltage 50V
C308: 4.7 uF; C_0402_1005Metric; Tolerance ±10%; Voltage 50V
C309: 15 pF; C_0402_1005Metric; Voltage 50 V
C310: 100 nF; C_0402_1005Metric; Tolerance 10 %; Voltage 10 V
C311: 3.2 pF; C_0402_1005Metric; Tolerance ±10%; Voltage 50V
C312, C313: 2.4 pF; C_0402_1005Metric; Tolerance ±10%; Voltage 50V
D301: LED; LED_0805_2012Metric
FL301: 2450BP08A0100001T; Manufacturer_Part_Number 2450BP08A0100001T
IC301: RMS-30+; RMS30; Manufacturer_Part_Number RMS-30+
IC302: SE2576L-R; QFN50P300X300X90-17N-D; Mouser Part Number 873-SE2576L-R
J301: CONMHF1-SMD-T; CONMHF1SMDT; Mouser Part Number 712-CONMHF1-SMD-T
L301: LQG15HN1N5S02D; LQG15WH0N7B02D; Mouser Part Number 81-LQG15HN1N5S02D
R301: 91; R_0402_1005Metric; Tolerance 5%
R302: 0; R_0603_1608Metric
R303: 100k; R_0603_1608Metric
R304: 1k; R_0603_1608Metric
R305: 26.7K; R_0603_1608Metric

Connections:
+5V: C305.1, C306.2, C307.1, C308.1, C310.1, IC302.4 (VCCO), IC302.13 (VCC2), R301.1, R302.1; also elsewhere on the board
/IO Interface/PA DET Output: IC302.7 (DET), R305.1; also elsewhere on the board
/IO Interface/PA Enable: D301.2 (A), IC302.2 (EN), R303.2; also elsewhere on the board
/Oscillator Splitter/Oscillator Tx: C301.2; also elsewhere on the board
/transmitter/Filtered Tx: FL301.4 (_IN/OUT), IC302.1 (RF_IN), J301.1 (SIGNAL)
/transmitter/RF Out: C303.2, FL301.1 (IN/OUT)
/transmitter/Tx In: C302.1; also elsewhere on the board
/transmitter/Tx Out: C313.1, L301.1; also elsewhere on the board
GND: C304.1, C305.2, C306.1, C307.2, C308.2, C310.2, C311.2, C312.2, C313.2, FL301.2 (GND_1), FL301.3 (GND_2), FL301.5 (GND_3), IC301.2 (GROUND_1), IC301.3 (GROUND_2), IC301.6 (GROUND_3), IC302.3 (GND_1), IC302.5 (GND_2), IC302.6 (GND_3), IC302.9 (GND_4), IC302.12 (GND_5), IC302.16 (GND_6), IC302.17 (EP_(GND)), J301.2 (GND_1), J301.3 (GND_2), J301.4 (GND_3), R303.1, R304.2, R305.2; also elsewhere on the board
unnamed: C309.2, L301.2
unnamed: D301.1 (K), R304.1
unnamed: C302.2, IC301.5 (IF)
unnamed: C301.1, IC301.1 (LO)
unnamed: C303.1, IC301.4 (RF)
unnamed: C309.1, C311.1, C312.1, IC302.10 (RFOUT), IC302.11 (RF_OUT), R302.2
unnamed: C304.2, IC302.15 (VCC1), R301.2

Notes on the sheet:
Place Thermal Vias for Heat Dissapation!
Eval Board https://www.eevblog.com/forum/rf-microwave/2-4ghz-amplifier-quadrature-hybrid-coupler-balanced/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;attach=686451
Amplifier
Mixer
Band pass
Place close together!

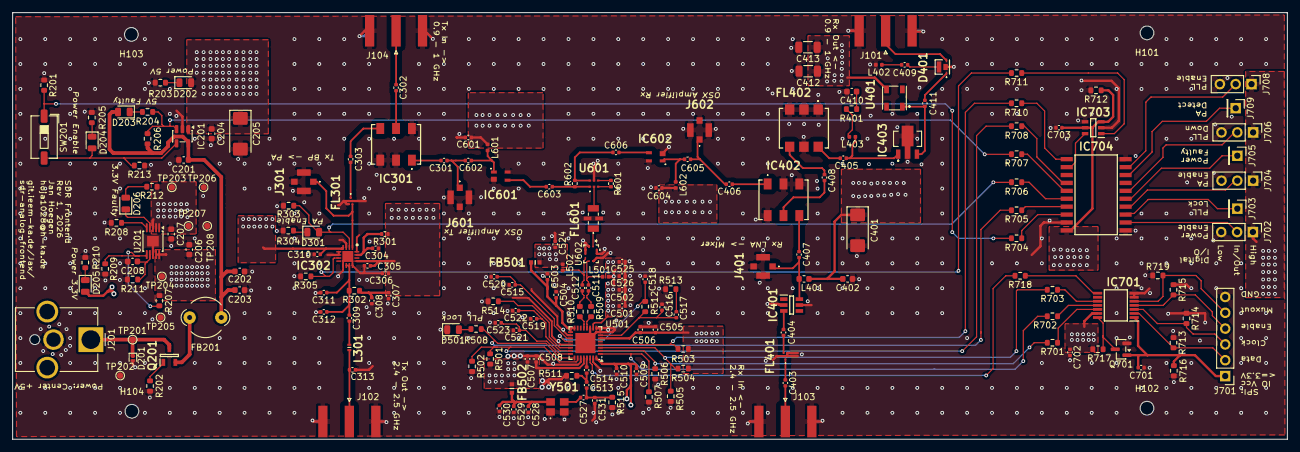
[picture p29: board main_v2.kicad_pcb from above]

Board: 4 copper layers, 204.7 x 68.5 mm, 201 parts (0 on the bottom side), 114 nets.
