JaxRaffnix/sdr-analog-frontend/(commit log)

2026-06-16 added schematic folder
2026-06-21 worked on layout
    [aisler-4-layer-hd-drc.kicad_pcb, aisler-4-layer-hd-drc.kicad_sch, main_v2.kicad_pcb, main_v2.kicad_sch, oscillator.kicad_sch, power.kicad_sch, receiver.kicad_sch, transmitter.kicad_sch]
2026-06-29 updated layout
    [main_v2.kicad_pcb, main_v2.kicad_sch, oscillator.kicad_sch, power.kicad_sch, receiver.kicad_sch, transmitter.kicad_sch]
2026-06-29 update layout
    [main_v2.kicad_pcb]
2026-07-04 added power budget
    [main_v2.kicad_pcb]
2026-07-04 updated schematic after review
    [main_v2.kicad_pcb, main_v2.kicad_sch, oscillator.kicad_sch, power.kicad_sch, receiver.kicad_sch, transmitter.kicad_sch]
2026-07-04 added bom to git
    [bom.csv]
2026-07-05 added new osci
    [main_v2.kicad_sch, oscillator.kicad_sch, oscillator2.kicad_sch, power.kicad_sch, transmitter.kicad_sch]
2026-07-05 updated schematic
    [io.kicad_sch, main_v2.kicad_sch, oscillator2.kicad_sch, power.kicad_sch, receiver.kicad_sch]
2026-07-05 updated pll
    [oscillator2.kicad_sch, power.kicad_sch, transmitter.kicad_sch]
2026-07-07 updarted schematic and simulation
    [io.kicad_sch, main_v2.kicad_pcb, main_v2.kicad_sch, oscillator.kicad_sch, pll.kicad_sch, power.kicad_sch, receiver.kicad_sch, splitter.kicad_sch]
2026-07-07 improved python mode
    [main_v2.kicad_pcb, splitter.kicad_sch]
2026-07-07 improved visualization
    [power.kicad_sch]
2026-07-08 added noise calc for simulation
    [io.kicad_sch, main_v2.kicad_pcb]
2026-07-09 updated io schematic
    [io.kicad_sch, main_v2.kicad_pcb, main_v2.kicad_sch, pll.kicad_sch, power.kicad_sch, receiver.kicad_sch, splitter.kicad_sch, transmitter.kicad_sch]
2026-07-09 update bom
    [io.kicad_sch, main_v2.csv, main_v2.kicad_pcb, main_v2.kicad_sch, pll.kicad_sch, power.kicad_sch, receiver.kicad_sch, splitter.kicad_sch]
2026-07-10 finished layout
    [io.kicad_sch, main_v2.kicad_pcb, main_v2.kicad_sch, power.kicad_sch, receiver.kicad_sch, splitter.kicad_sch, transmitter.kicad_sch]
2026-07-11 minor documentaion updates
    [main_v2.csv, main_v2.kicad_pcb]
2026-07-12 updated spi connection
    [io.kicad_sch, main_v2.kicad_pcb, main_v2.kicad_sch, pll.kicad_sch]
2026-07-13 added ground via for every pad
    [main_v2.kicad_pcb]
2026-07-18 update do docs and minor layout fix
    [io.kicad_sch, main_v2.kicad_pcb, pll.kicad_sch, power.kicad_sch, receiver.kicad_sch, splitter.kicad_sch, transmitter.kicad_sch]
2026-07-19 updated bom
    [bom.csv, main_v2.csv]
2026-07-19 added second LNA
    [main_v2.kicad_pcb, main_v2.kicad_sch, receiver.kicad_sch]
2026-07-25 added bestellformular
    [Bestellung.xlsx, Lieferantenliste.xlsx]
2026-07-28 updated bestellung
    [Bestellung.xlsx]
2026-08-18 added new doc files
    [Auslagenerstattung.xlsx, Bestellung.xlsx, bom.csv, pll.kicad_sch, power.kicad_sch]
2026-08-19 added assembly notes
    [Bestellung neu.xlsx]
2026-08-19 updated project after assembly
    [Bestellung 2.xlsx, Bestellung neu.xlsx, bom.csv, main_v2.kicad_pcb, pll.kicad_sch, power.kicad_sch, receiver.kicad_sch, transmitter.kicad_sch]
2026-08-19 updated bestellung 2
    [Bestellung 2.xlsx]
2026-08-19 resynched layout
    [main_v2.kicad_pcb]
2026-08-20 updated assembly notes
2026-09-17 updated order info
    [Auslagenerstattung 2.xlsx, Auslagenerstattung.xlsx, Bestellung 2.xlsx, Bestellung.xlsx, Lieferantenliste.xlsx]
